MazinLab/huskypointofload/bom.xlsx

Reference | Qty | DIGIKEY_PN | Footprint | Value
Y1 | 1 | 2151-RH100-16.000-8-2020-TRCT-ND | Crystal:Crystal_SMD_3225-4Pin_3.2x2.5mm_HandSoldering | 16MHz
U11 | 1 | 4518-USBLC6-2SC6CT-ND | Package_TO_SOT_SMD:SOT-23-6 | USBLC6-2SC6
U10 | 1 | LTC2851IMS8#TRPBFCT-ND | Package_SO:SOIC-8_3.9x4.9mm_P1.27mm | LTC2851xS8
U9 | 1 | 497-STM32G474MBT6-ND | Package_QFP:LQFP-80_12x12mm_P0.5mm | STM32G474MBTx
U7,U8 | 2 | 505-LT3045EDD#PBF-ND | Package_DFN_QFN:DFN-10-1EP_3x3mm_P0.5mm_EP1.65x2.38mm | LT3045xDD
U5,U6 | 2 | 296-LMR36510ADDARCT-ND | Package_SO:Texas_HTSOP-8-1EP_3.9x4.9mm_P1.27mm_EP2.95x4.9mm_Mask2.4x3.1mm_ThermalVias | LMR36510ADDA
U4 | 1 | 505-LT8625SIV#TRMPBFCT-ND | Package_DFN_QFN:QFN-20-1EP_3x4mm_P0.5mm_EP1.65x2.65mm | LT8625S
U3 | 1 | 917-EPC23104ENGRTCT-ND | Package_DFN_QFN:EPC_QFN-13-3EP_3.5x5mm_P0.5mm | EPC23104
U1,U2 | 2 | 296-INA290A2IDCKRCT-ND | Package_TO_SOT_SMD:SOT-353_SC-70-5 | INA290A2xDCK
TP8 | 1 | 36-5015CT-ND | TestPoint:TestPoint_Keystone_5015_Micro_Mini | BOOT0
TP7 | 1 | 36-5015CT-ND | TestPoint:TestPoint_Keystone_5015_Micro_Mini | VBUS
TP6 | 1 | 36-5015CT-ND | TestPoint:TestPoint_Keystone_5015_Micro_Mini | LNSW
TP5 | 1 | 36-5015CT-ND | TestPoint:TestPoint_Keystone_5015_Micro_Mini | PHMODE
TP4 | 1 | 36-5015CT-ND | TestPoint:TestPoint_Keystone_5015_Micro_Mini | CLKOUT
TP3 | 1 | 36-5015CT-ND | TestPoint:TestPoint_Keystone_5015_Micro_Mini | VC
TP2 | 1 | 36-5015CT-ND | TestPoint:TestPoint_Keystone_5015_Micro_Mini | INTVCC
TP1 | 1 | 36-5015CT-ND | TestPoint:TestPoint_Keystone_5015_Micro_Mini | GANSW
SW2 | 1 | CKN10502CT-ND | Button_Switch_SMD:SW_SPST_PTS810 | BOOT0
SW1 | 1 | CKN10502CT-ND | Button_Switch_SMD:SW_SPST_PTS810 | SYS_RESET
R43,R44 | 2 | P27.0LCT-ND | Resistor_SMD:R_0402_1005Metric | 27
R39,R40 | 2 | 311-120LRCT-ND | Resistor_SMD:R_0402_1005Metric | 120
R33,R36 | 2 | 311-200KJRCT-ND | Resistor_SMD:R_0402_1005Metric | 200k
R31,R32 | 2 | YAG2304CT-ND | Resistor_SMD:R_0402_1005Metric | 100k
R29,R34,R37 | 3 | 311-10.0LRCT-ND | Resistor_SMD:R_0402_1005Metric | 10
R28 | 1 | YAG4390CT-ND | Resistor_SMD:R_0402_1005Metric | 47.5k
R26 | 1 | 311-499LRCT-ND | Resistor_SMD:R_0402_1005Metric | 499
R23,R24,R27 | 3 | YAG3471CT-ND | Resistor_SMD:R_0402_1005Metric | 2.2
R21,R22,R25,R41,R42 | 5 | 311-4.7KJRCT-ND | Resistor_SMD:R_0402_1005Metric | 4.7k
R19,R20 | 2 | 311-0.0JRCT-ND | Resistor_SMD:R_0402_1005Metric | 0
R16,R18 | 2 | YAG4374CT-ND | Resistor_SMD:R_0402_1005Metric | 33k
R15,R17 | 2 | 13-RC0402FR-13453KLCT-ND | Resistor_SMD:R_0402_1005Metric | 453k
R14 | 1 | 738-RNCF0402BTE40K0CT-ND | Resistor_SMD:R_0402_1005Metric | 40k
R13 | 1 | YAG3129CT-ND | Resistor_SMD:R_0402_1005Metric | 357k
R10 | 1 | P43.2KDCCT-ND | Resistor_SMD:R_0402_1005Metric | 43.2k
R9 | 1 | YAG4360CT-ND | Resistor_SMD:R_0402_1005Metric | 24.9k
R7 | 1 | 541-MCS0402MD1004BE000CT-ND | Resistor_SMD:R_0402_1005Metric | 1M
R4,R5,R6,R8,R12,R30,R35,R38 | 8 | YAG4394CT-ND | Resistor_SMD:R_0402_1005Metric | 49.9k
R3,R11 | 2 | 2019-RN73R1ETTP2673B25CT-ND | Resistor_SMD:R_0402_1005Metric | 267k
R1,R2 | 2 | YAG2145CT-ND | Resistor_SMD:R_2512_6332Metric | 5m
L5,L6 | 2 | SRN6045-220MCT-ND | Inductor_SMD:L_Bourns_SRN6045TA | 22u
L4 | 1 | 118-SRP7028AA-R22MCT-ND | Inductor_SMD:L_Bourns_SRP7028A_7.3x6.6mm | 220n
L3 | 1 | SRP5030T-1R0MCT-ND | Inductor_SMD:L_Bourns_SRP5030T | 1u
L2 | 1 | SRP1245A-1R5MCT-ND | Inductor_SMD:L_Bourns_SRP1245A | 1.5u
L1 | 1 | SRR1260-1R0YCT-ND | Inductor_SMD:L_Bourns_SRR1260 | 1u
J9 | 1 | 670-DX07S016JA1R1500CT-ND | Connector_USB:USB_C_Receptacle_JAE_DX07S016JA1R1500 | USB-C
J8 | 1 | SAM1161-05-ND | Connector_PinHeader_1.27mm:PinHeader_2x05_P1.27mm_Vertical_SMD | JTAG
J7 | 1 | 2946-233-504-ND | TerminalBlock_WAGO:TerminalBlock_WAGO_233-504_2x04_P2.54mm | RS485
J3 | 1 | 2946-2601-1102-ND | TerminalBlock_WAGO:TerminalBlock_WAGO_2601-1102_1x02_P3.50mm_Horizontal | RFSOC_POWER
J2,J4,J5,J6 | 4 | ARF2755-ND | Connector_Coaxial:SMA_Amphenol_132134-10_Vertical | VSENSE
J1 | 1 | 2946-2601-1105-ND | TerminalBlock_WAGO:TerminalBlock_WAGO_2601-1105_1x05_P3.50mm_Horizontal | POWER
FB1 | 1 | 732-6119-1-ND | Inductor_SMD:L_0603_1608Metric | 74279228600
F2 | 1 | F2973CT-ND | Fuse:Fuseholder_Littelfuse_Nano2_157x | 5A
F1 | 1 | F2973CT-ND | Fuse:Fuseholder_Littelfuse_Nano2_157x | 10A
D1,D2,D3,D4,D5,D6,D7,D8 | 8 | DFLS1150DICT-ND | Diode_SMD:D_PowerDI-123 | DFLS1150
C78,C80 | 2 | 490-13339-1-ND | Capacitor_SMD:C_0402_1005Metric | 1u
C76,C77 | 2 | 490-11190-1-ND | Capacitor_SMD:C_0402_1005Metric | 12p
C71,C74 | 2 |  | Capacitor_SMD:C_0201_0603Metric | DNP
C70,C73 | 2 | 490-10727-1-ND | Capacitor_SMD:C_0603_1608Metric | 10u
C69,C72 | 2 | 490-GRM31CZ72A475ME11LCT-ND | Capacitor_SMD:C_1206_3216Metric | 4.7u
C59,C60,C61,C66,C67,C68 | 6 | 490-14659-1-ND | Capacitor_SMD:C_0603_1608Metric | 22u
C56,C63 | 2 | 490-GRM155R61J224ME01JCT-ND | Capacitor_SMD:C_0402_1005Metric | 220n
C54 | 1 | 490-GCM155R71H471KA37JCT-ND | Capacitor_SMD:C_0402_1005Metric | 470p
C52 | 1 | 490-13981-1-ND | Capacitor_SMD:C_0805_2012Metric | 100u
C50,C51 | 2 | 490-NFM18PC106D0J3LCT-ND | Capacitor_SMD:C_0402_1005Metric | 10u
C48 | 1 | 490-GRM155R60J226ME11DCT-ND | Capacitor_SMD:C_0402_1005Metric | 22u
C47,C49 | 2 | 490-GRM033R60J225ME01DCT-ND | Capacitor_SMD:C_0201_0603Metric | 2.2u
C44 | 1 | 490-GCM1555C1H820JA16DCT-ND | Capacitor_SMD:C_0402_1005Metric | 82p
C43,C75,C79 | 3 | 490-6351-1-ND | Capacitor_SMD:C_0402_1005Metric | 10n
C41,C46,C57,C64 | 4 | 490-14409-1-ND | Capacitor_SMD:C_0402_1005Metric | 1u
C22 | 1 | 490-GRM022R61C104ME05LCT-ND | Capacitor_SMD:C_0402_1005Metric | 100n
C19,C21,C53 | 3 |  | Capacitor_SMD:C_0402_1005Metric | DNP
C18,C20 | 2 | 490-6418-1-ND | Capacitor_SMD:C_0603_1608Metric | 2.2u
C14,C16,C17 | 3 | 490-5839-1-ND | Capacitor_SMD:C_2220_5750Metric | 22u
C8,C10,C12,C55,C62 | 5 | 490-GRM21BD72A225ME01KCT-ND | Capacitor_SMD:C_0805_2012Metric | 2.2u
C7,C9,C11,C13,C15 | 5 | 490-3285-1-ND | Capacitor_SMD:C_0603_1608Metric | 100n
C4,C5,C6,C23,C24,C25,C26,C27,C34,C35,C36,C37 | 12 | 490-GRM31CC71E226ME15LCT-ND | Capacitor_SMD:C_1206_3216Metric | 22u
C3,C28,C29,C30,C31,C32,C33,C38,C39,C40,C42 | 11 | 490-12732-1-ND | Capacitor_SMD:C_0603_1608Metric | 2.2u
C1,C2,C45,C58,C65,C81,C82,C83,C84,C85,C86 | 11 | 490-14603-1-ND | Capacitor_SMD:C_0402_1005Metric | 100n
