MazinLab/huskypointofload/huskypointofload.pdf

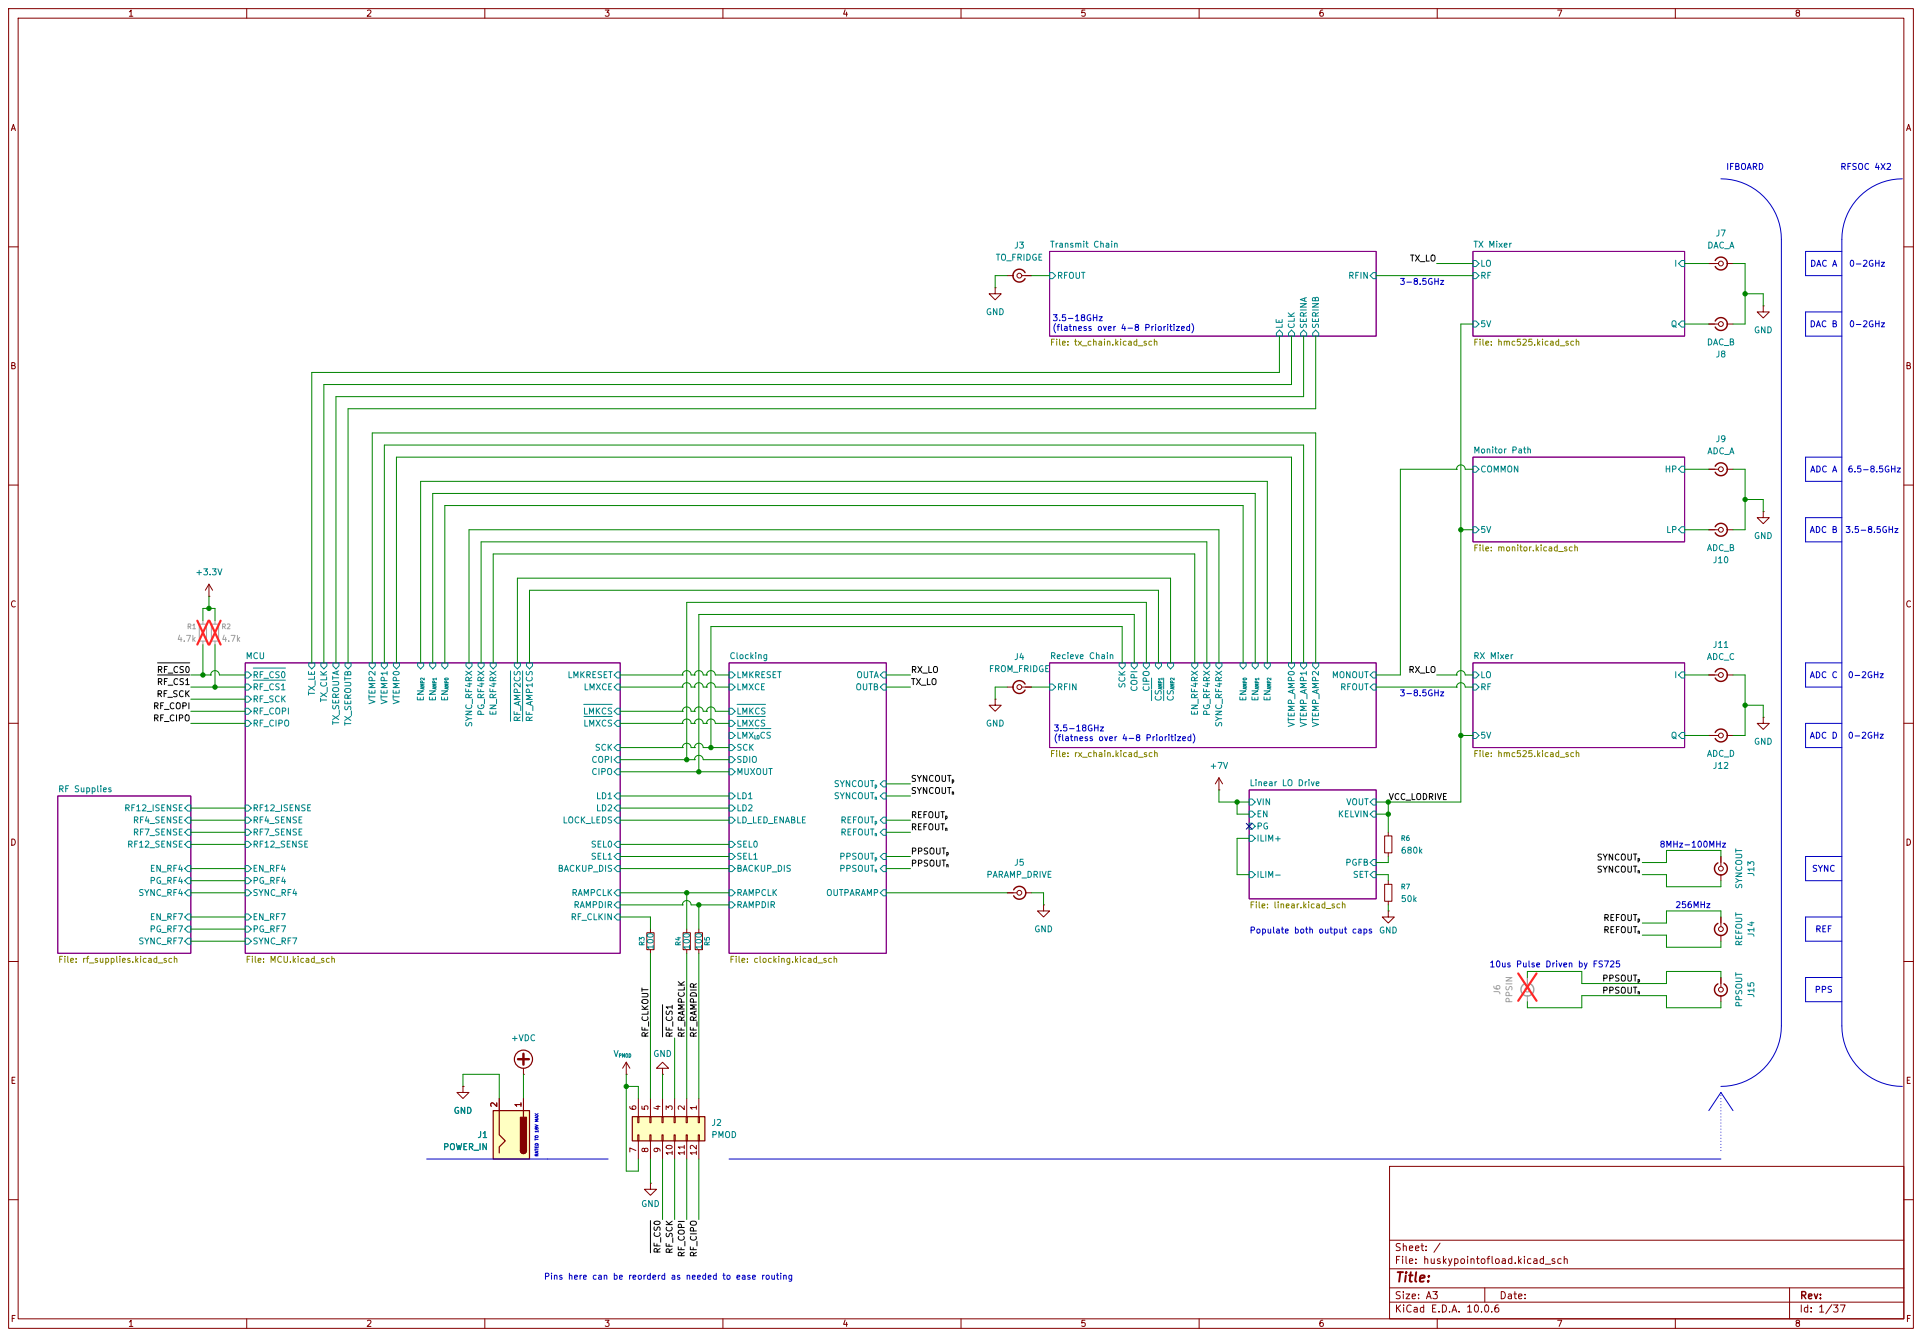
[picture p1: page 1]

TX Mixer File: hmc525.kicad_sch LECLK

LMKRESET BACKUP_DIS RAMPCLK
0-2GHz Pins here can be reorderd as needed to ease routing RATED TO 18V MAX

Populate both output caps

Size: A3 | Rev: | F Date:
KiCad E.D.A. 10.0.6 | Id: 1/37

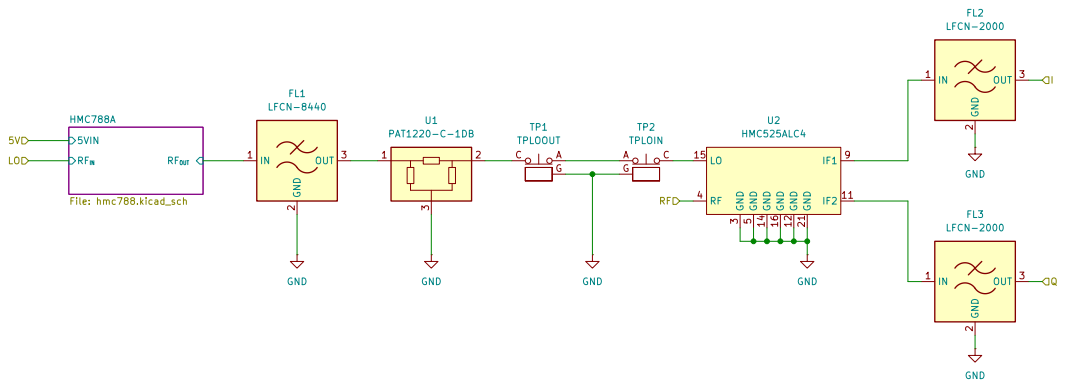
[picture p2: page 2]

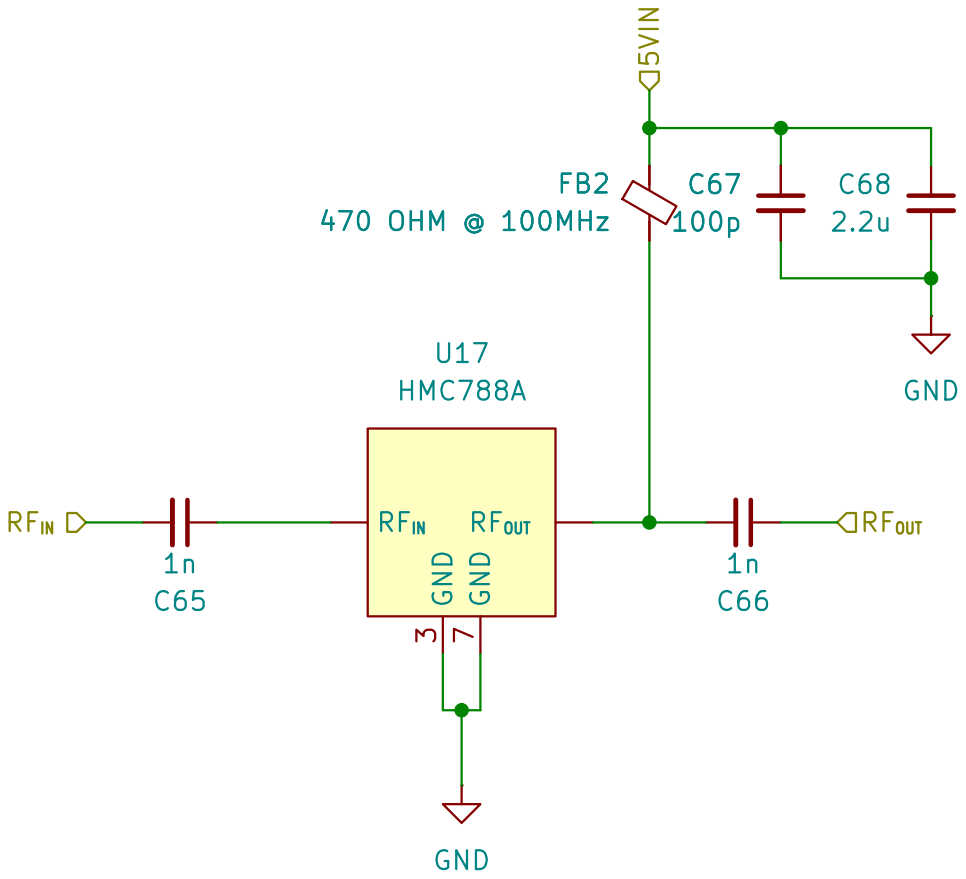
[picture p3: page 3]

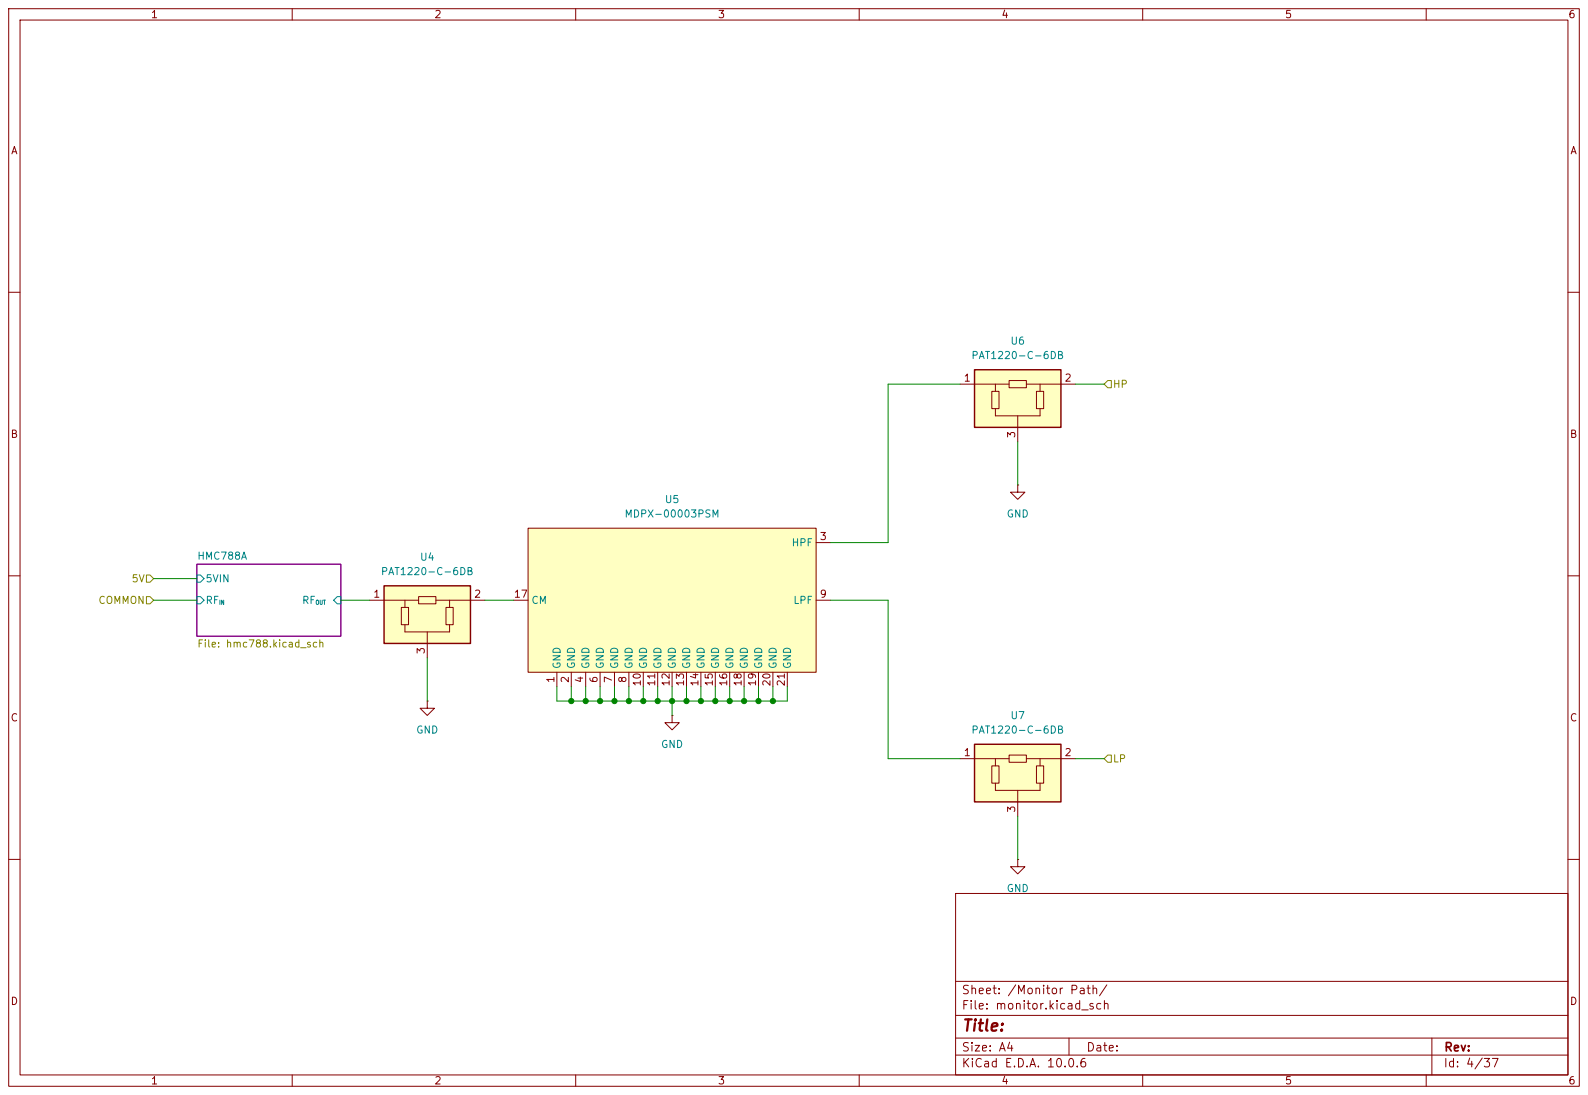
[picture p4: page 4]

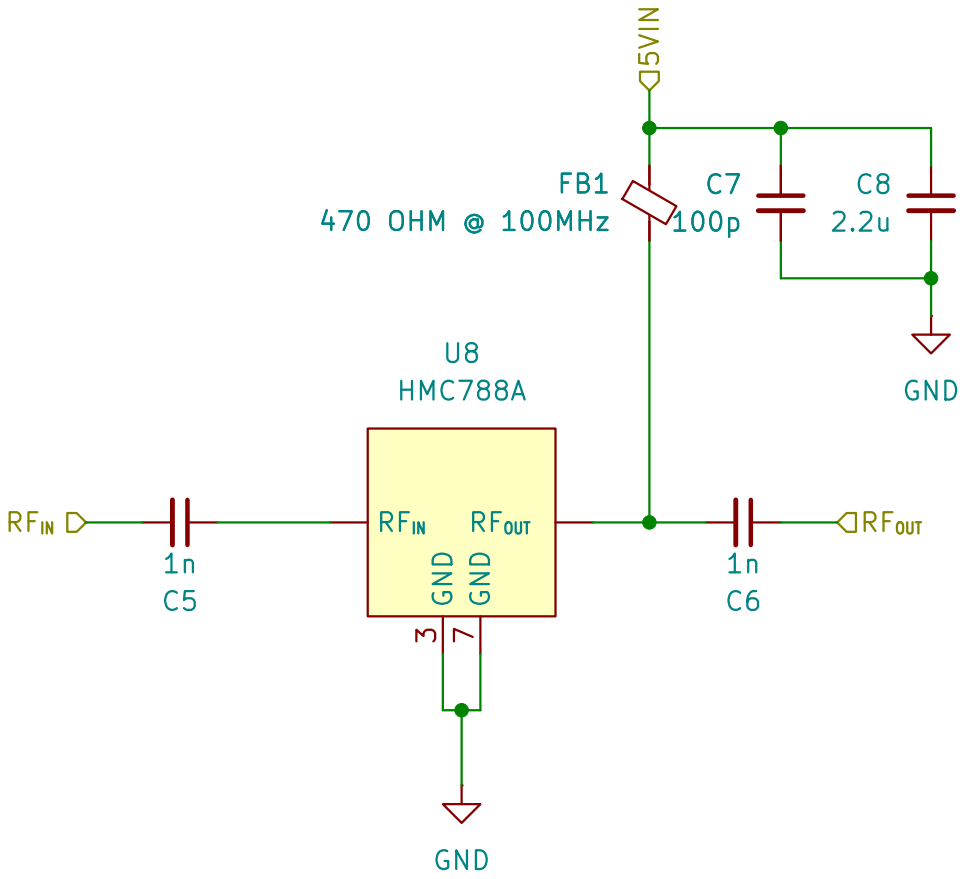
[picture p5: page 5]

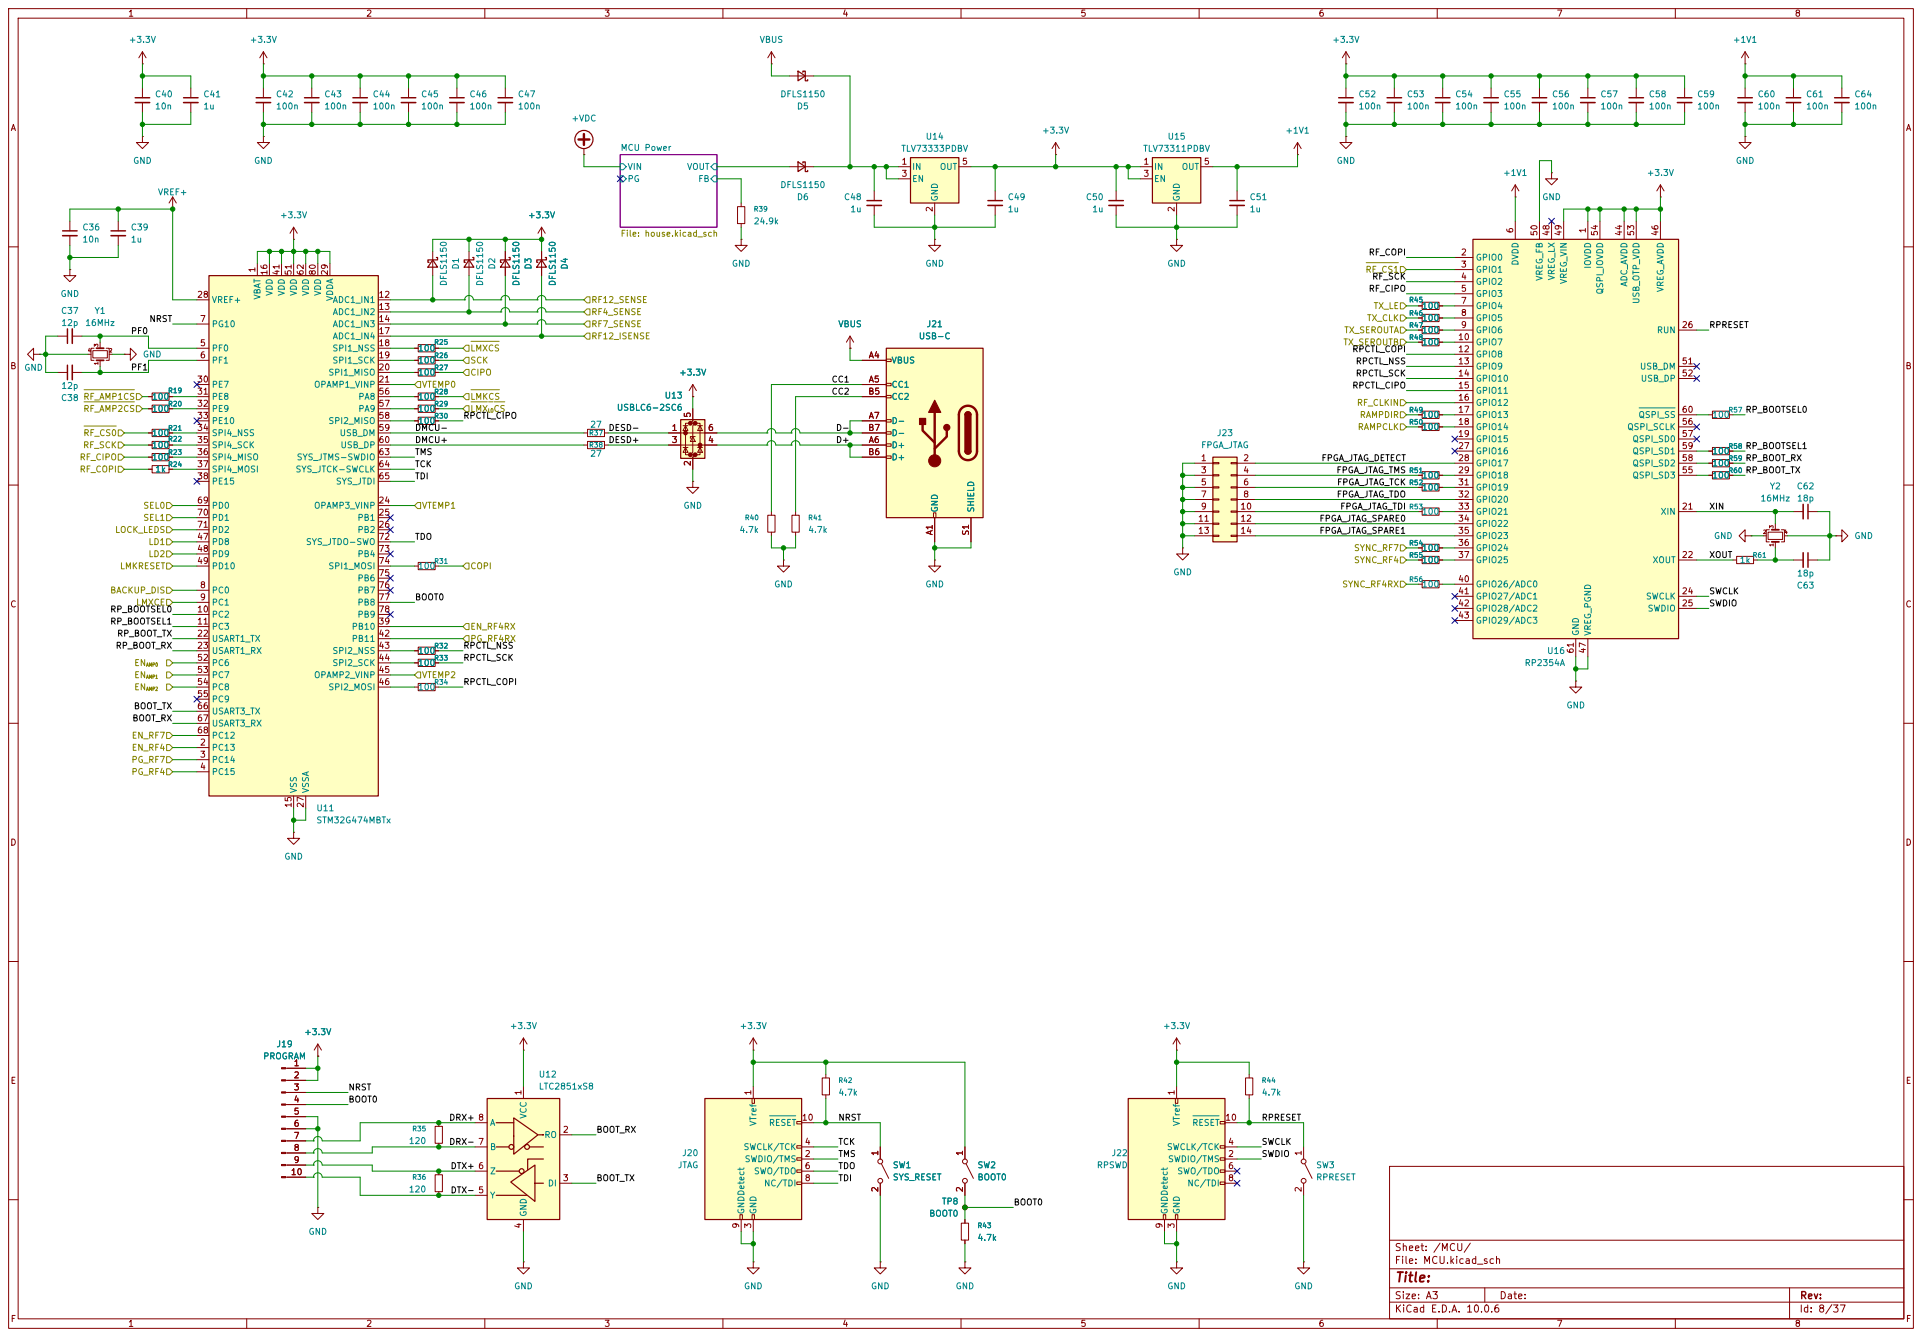
[picture p6: page 6]

7 | R52100 R52100 8 FPGA_JTAG_TDI FPGA_JTAG_TDO

11 | 12 FPGA_JTAG_SPARE0
13 | 14

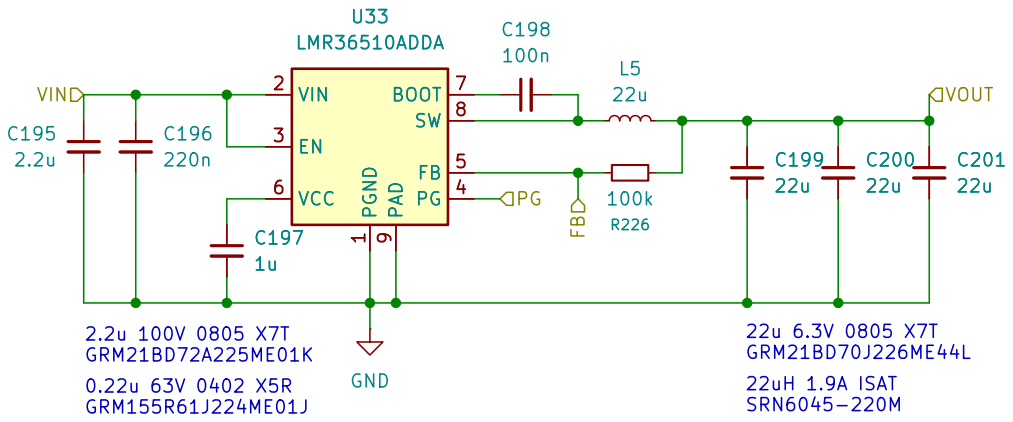
[picture p7: page 7]

Sheet: /MCU/MCU Power/
File: house.kicad_sch

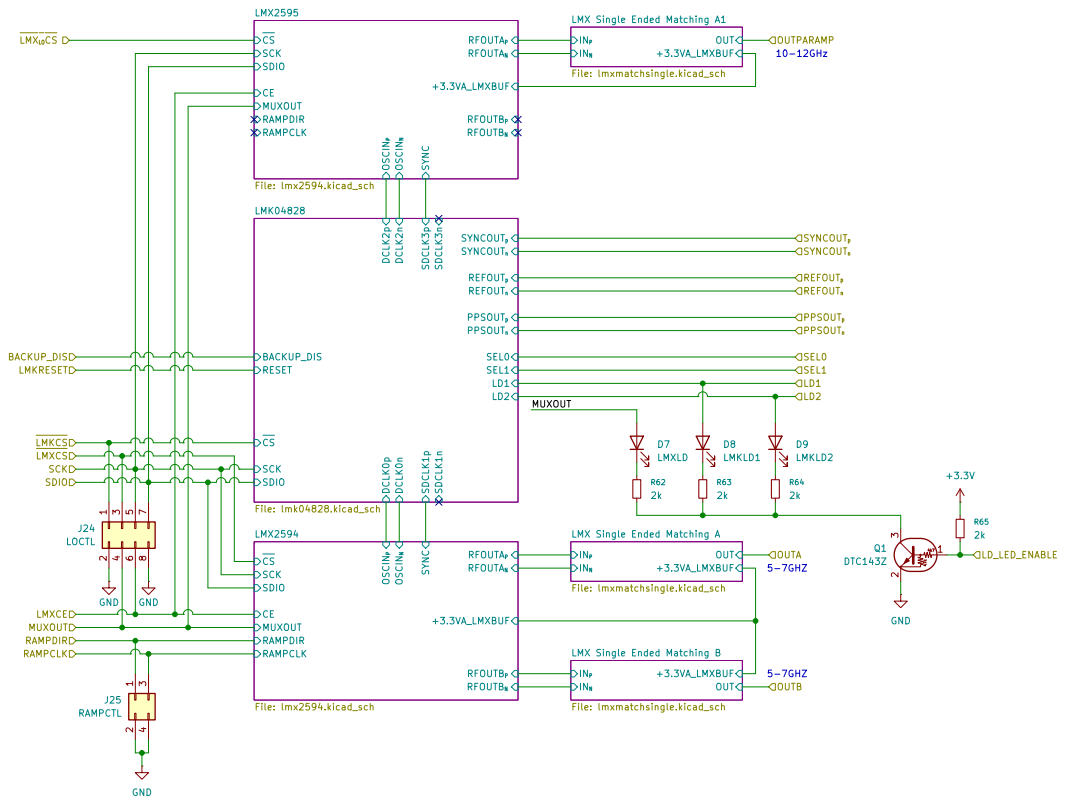
[picture p8: page 8]

LMX Single Ended Matching A1

RFOUTAN RFOUTAP RFOUTBN RFOUTBP SCK

LMX Single Ended Matching A

LMX Single Ended Matching B

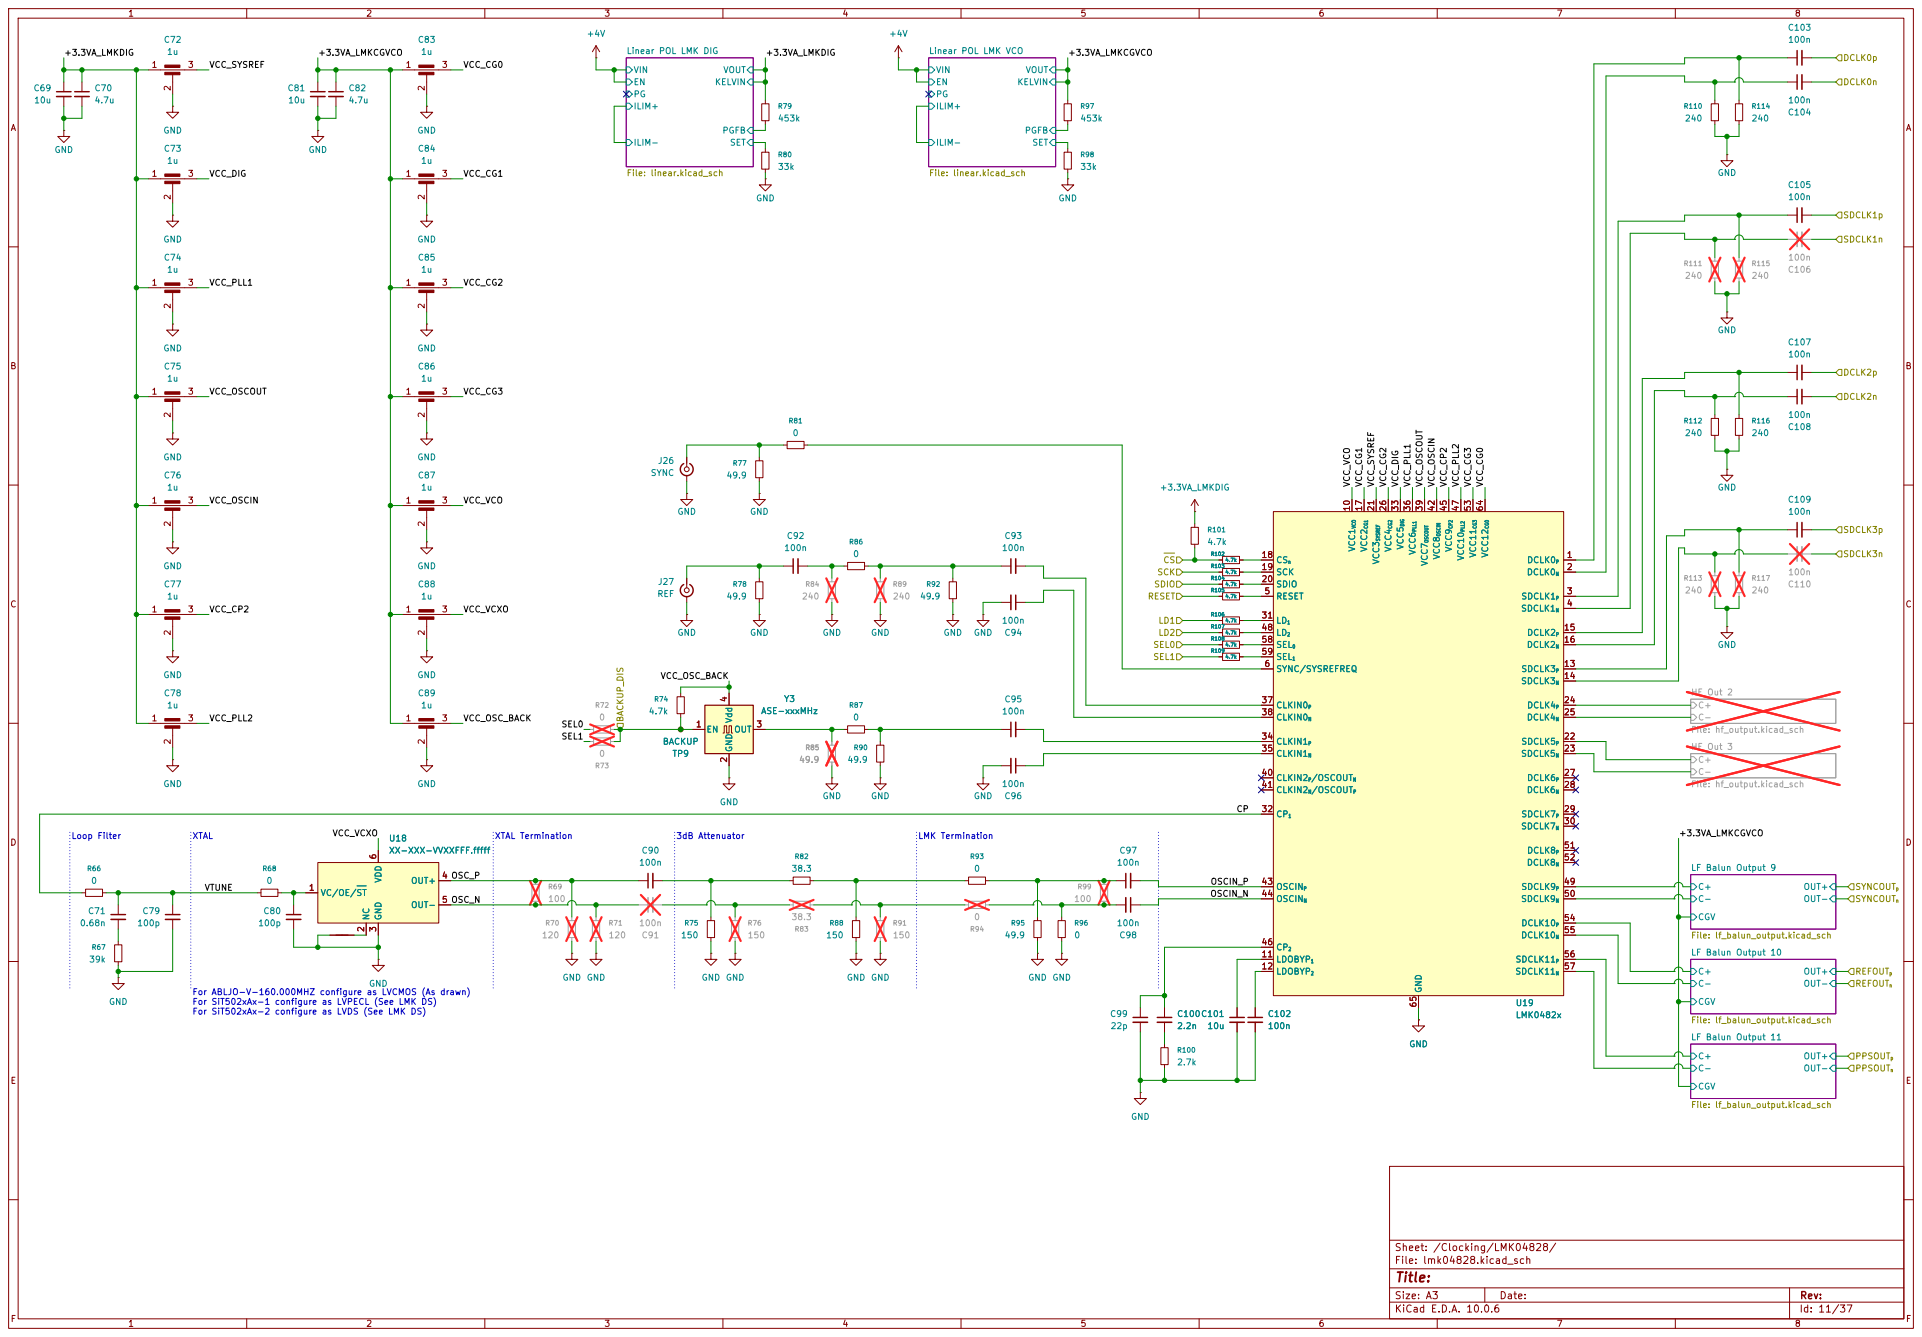
[picture p9: page 9]

Linear POL LMK DIG

Linear POL LMK VCO

PPSOUTn PPSOUTp REFOUTp REFOUTn SYNCOUTn SYNCOUTp BACKUP_DIS

3dB Attenuator For ABLJO-V-160.000MHZ configure as LVCMOS (As drawn) For SiT502xAx-1 configure as LVPECL (See LMK DS) For SiT502xAx-2 configure as LVDS (See LMK DS)

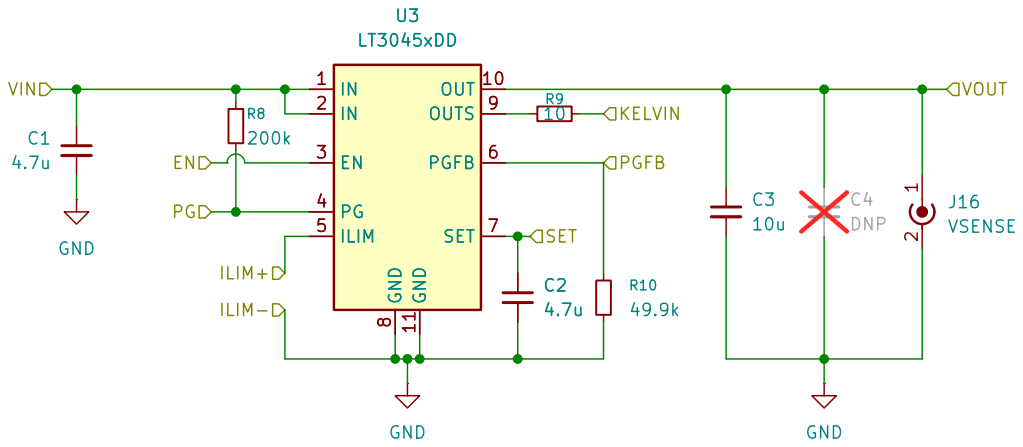
[picture p10: page 10]

Sheet: /Clocking/LMK04828/Linear POL LMK DIG/
File: linear.kicad_sch

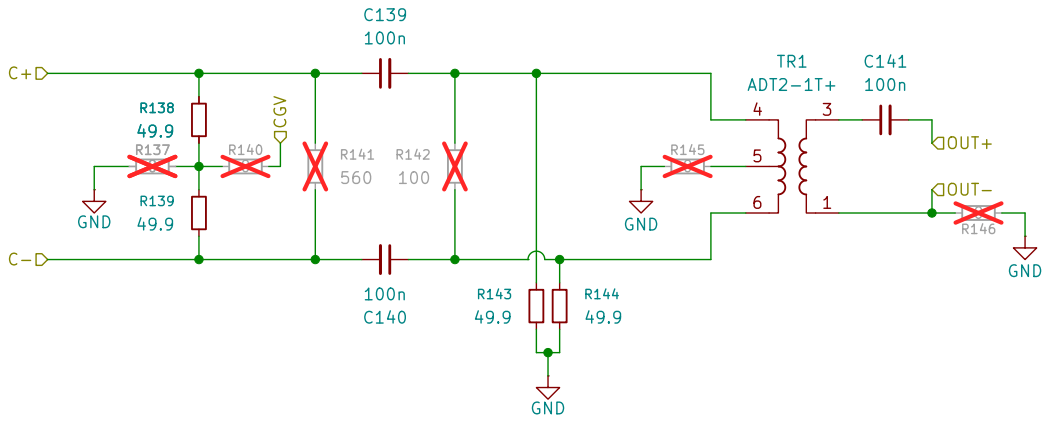
[picture p11: page 11]

Sheet: /Clocking/LMK04828/LF Balun Output 9/
File: lf_balun_output.kicad_sch
Title:

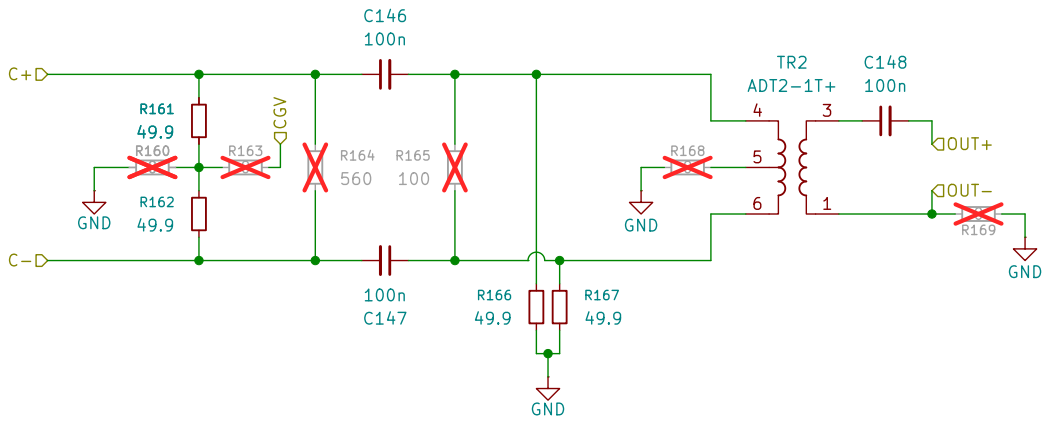
[picture p12: page 12]

Sheet: /Clocking/LMK04828/LF Balun Output 10/
File: lf_balun_output.kicad_sch
Title:

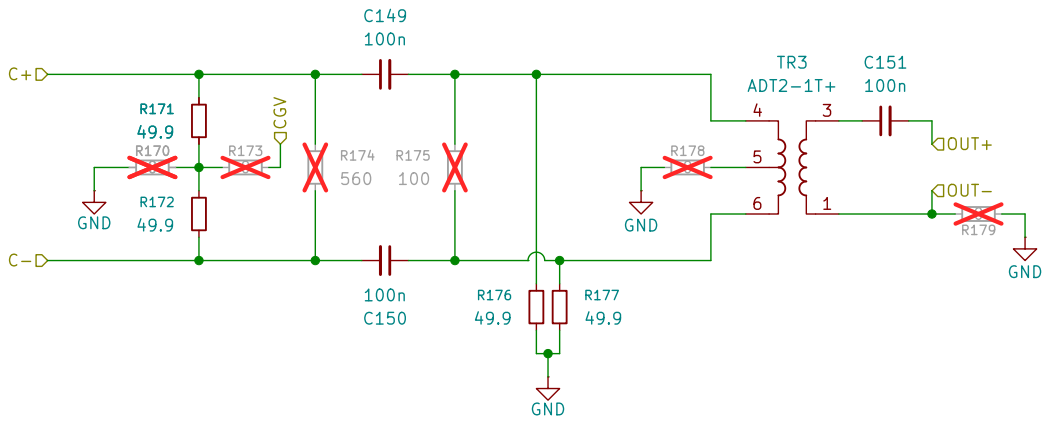
[picture p13: page 13]

Sheet: /Clocking/LMK04828/LF Balun Output 11/
File: lf_balun_output.kicad_sch
Title:

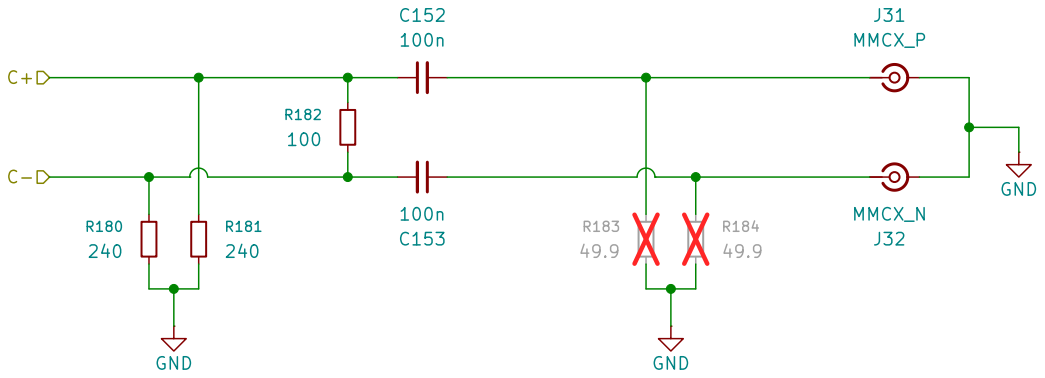
[picture p14: page 14]

Sheet: /Clocking/LMK04828/HF Out 2/
File: hf_output.kicad_sch
Title:

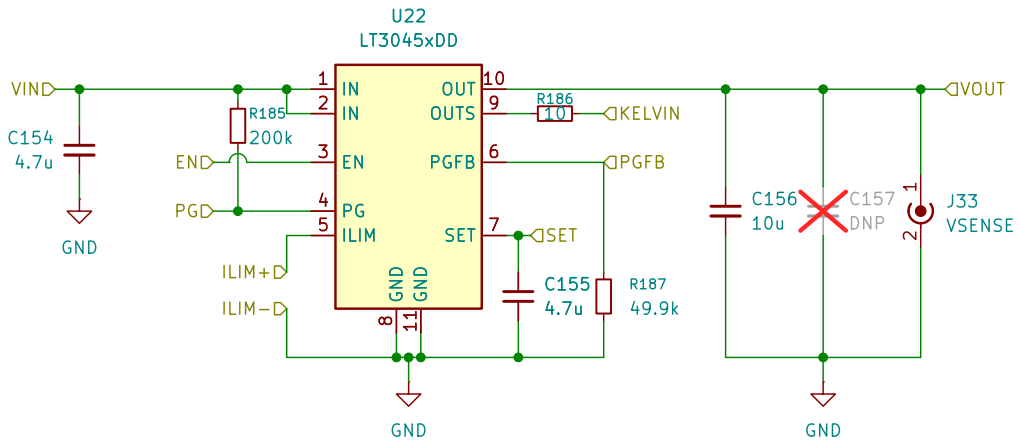
[picture p15: page 15]

Sheet: /Clocking/LMK04828/Linear POL LMK VCO/
File: linear.kicad_sch

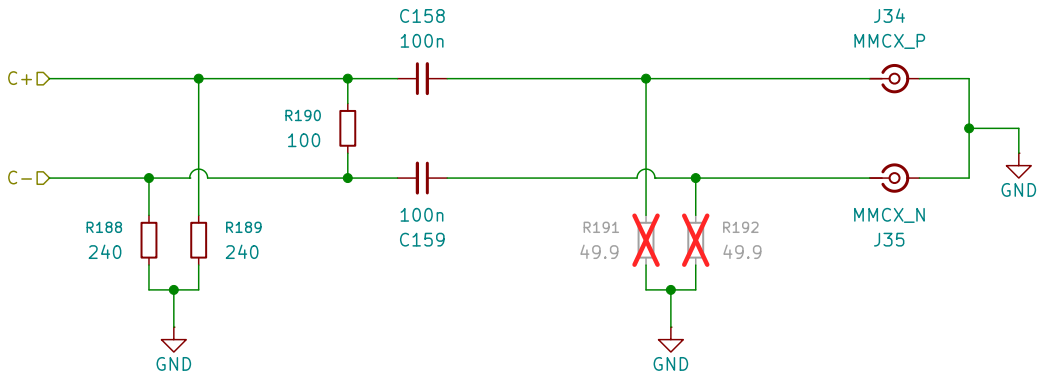
[picture p16: page 16]

Sheet: /Clocking/LMK04828/HF Out 3/
File: hf_output.kicad_sch
Title:

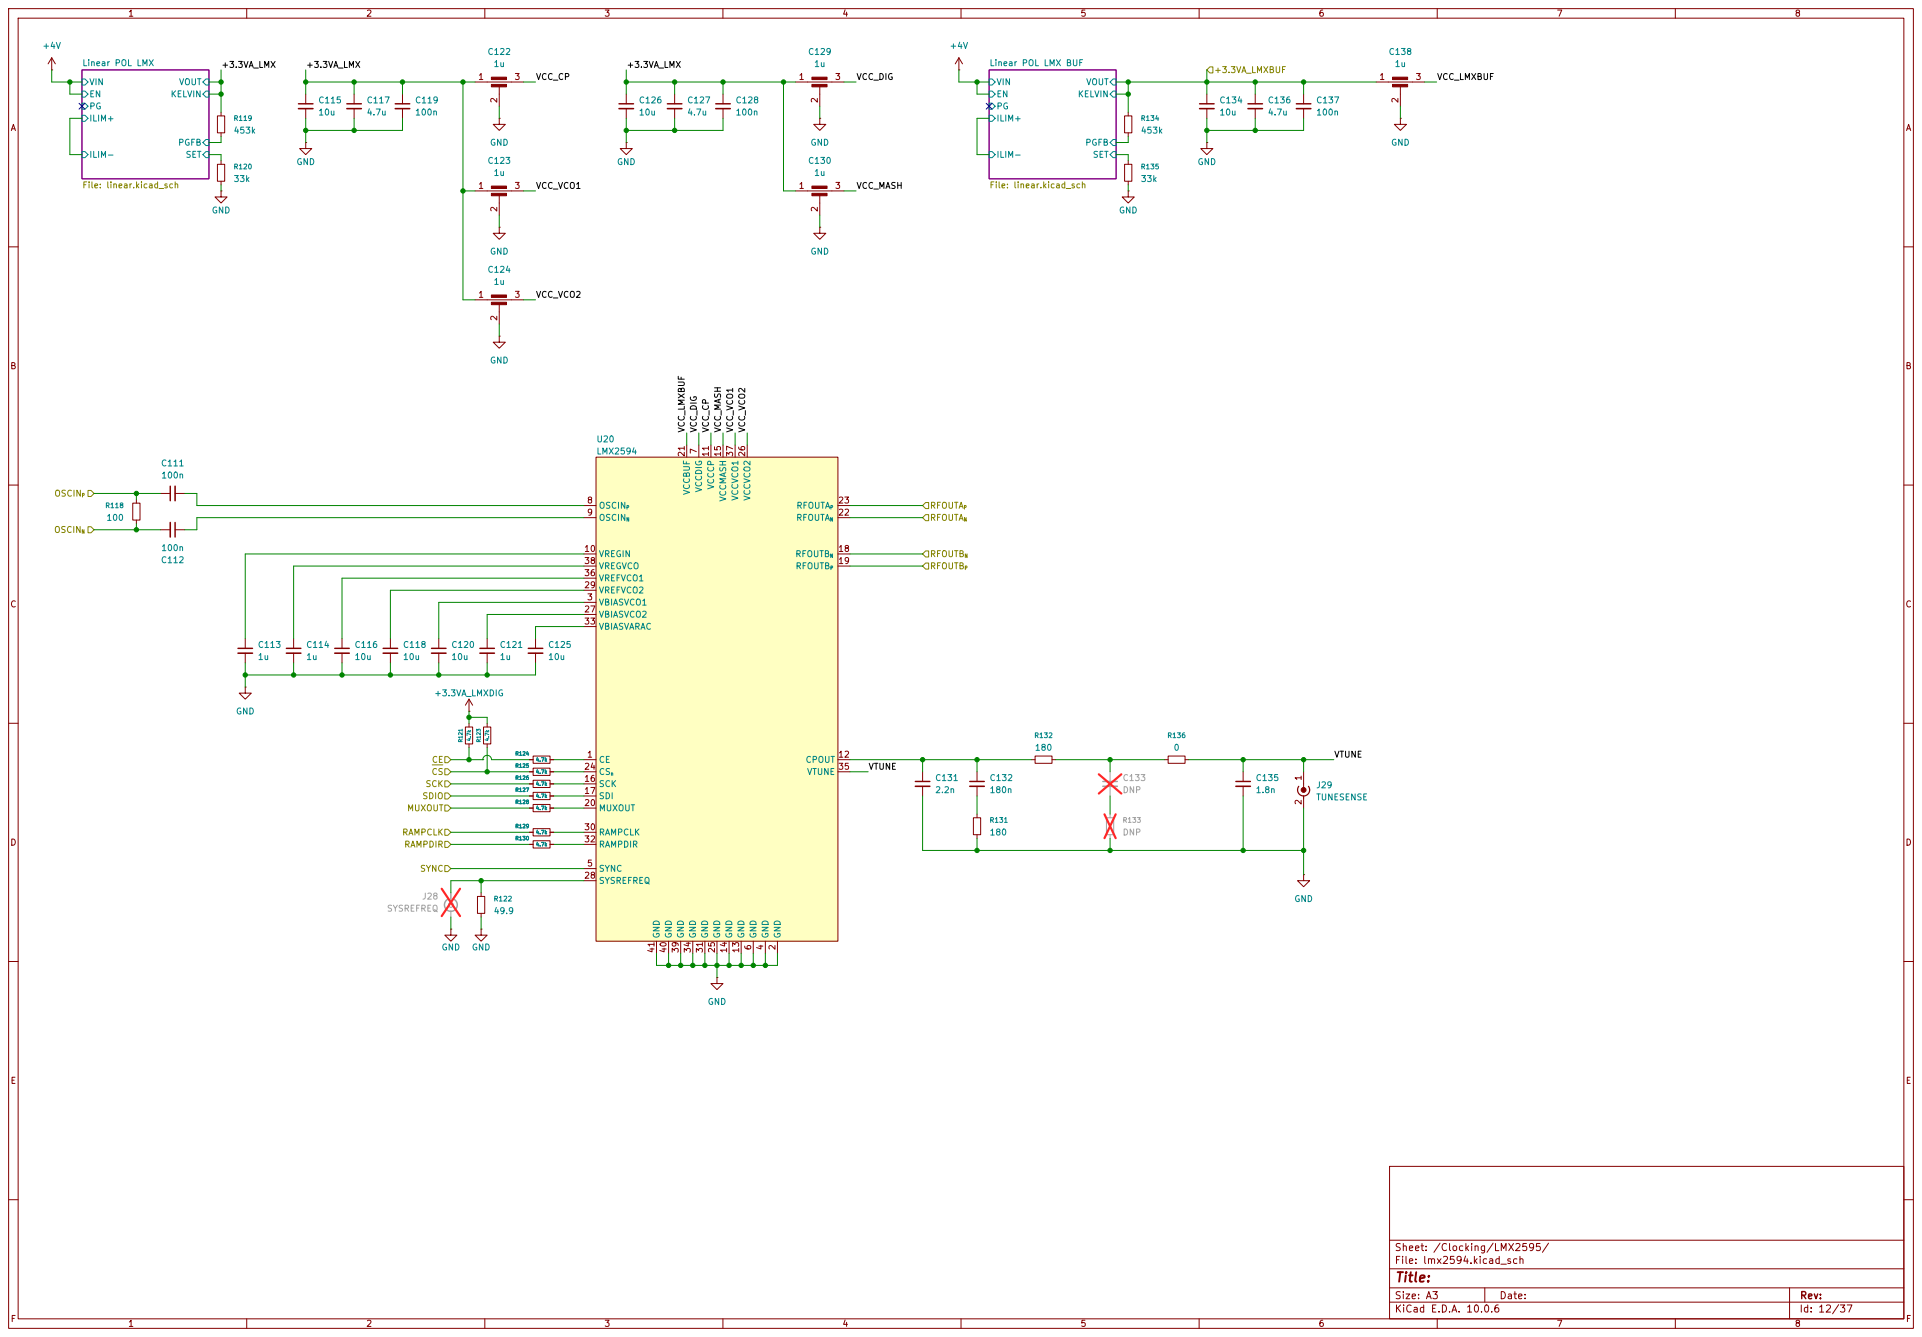
[picture p17: page 17]

+3.3VA_LMXBUF RFOUTAN RFOUTBN RFOUTBP RFOUTAP RAMPDIR

Linear POL LMX BUF

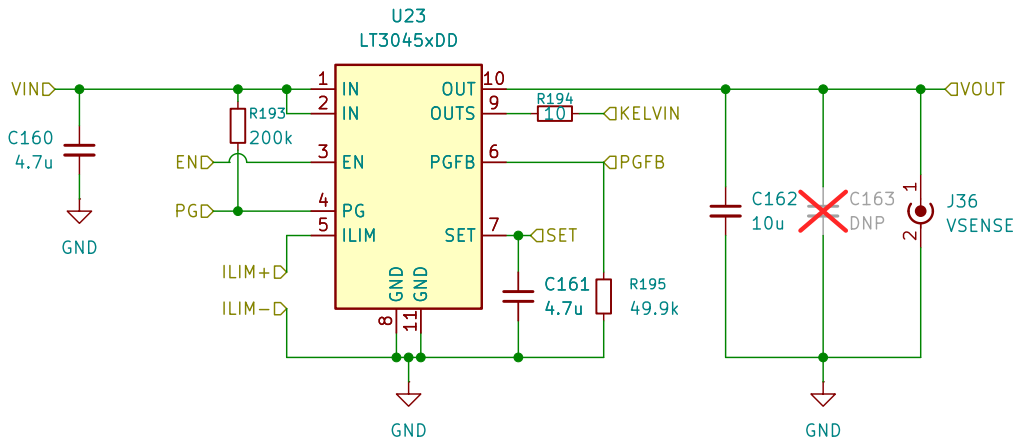
[picture p18: page 18]

Sheet: /Clocking/LMX2595/Linear POL LMX BUF/
File: linear.kicad_sch

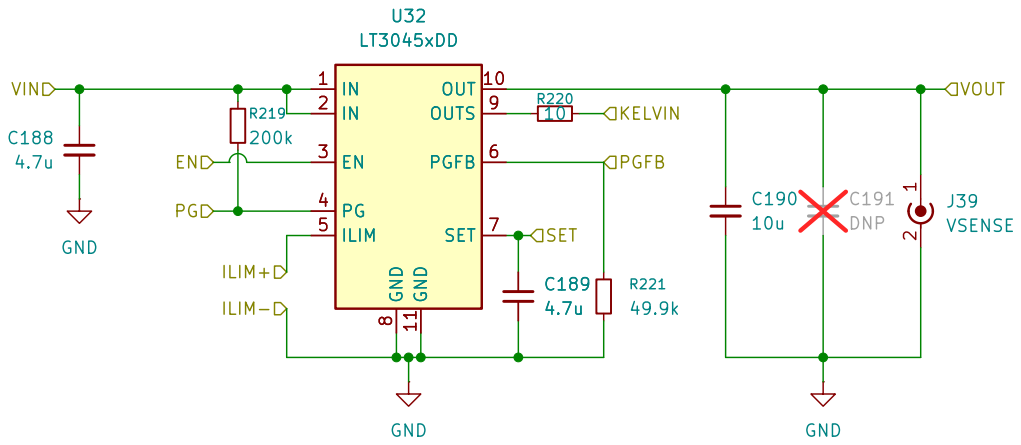
[picture p19: page 19]

Sheet: /Clocking/LMX2595/Linear POL LMX/
File: linear.kicad_sch

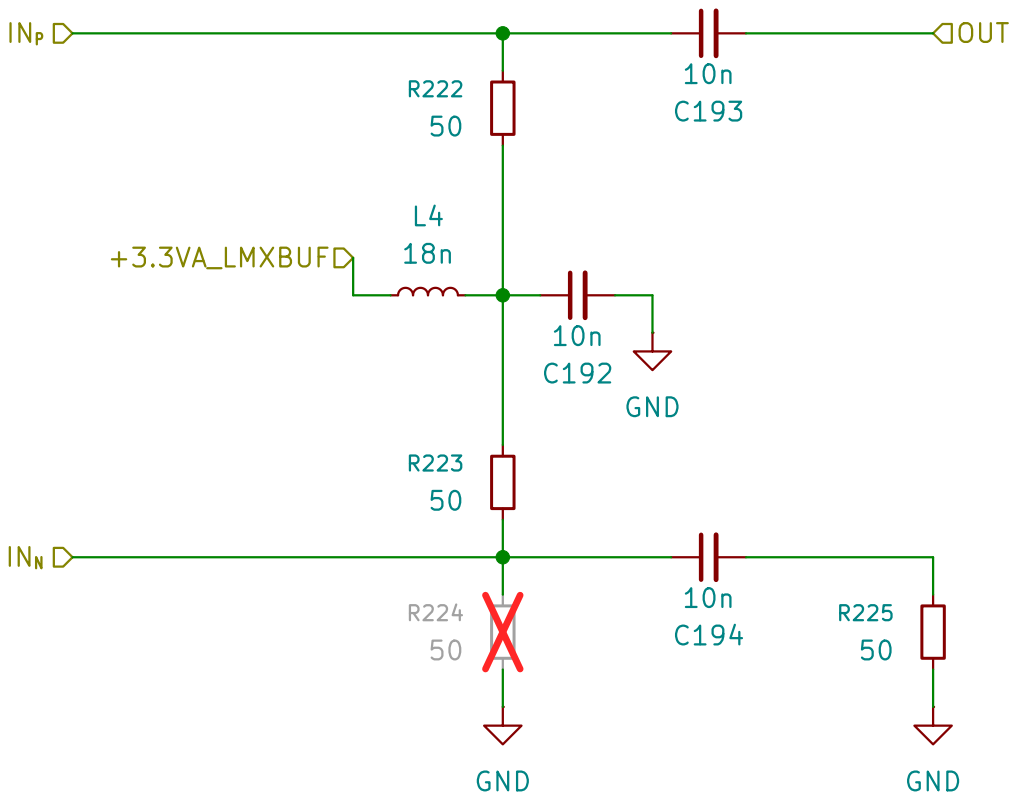
[picture p20: page 20]

Sheet: /Clocking/LMX Single Ended Matching A1/
File: lmxmatchsingle.kicad_sch
Title:

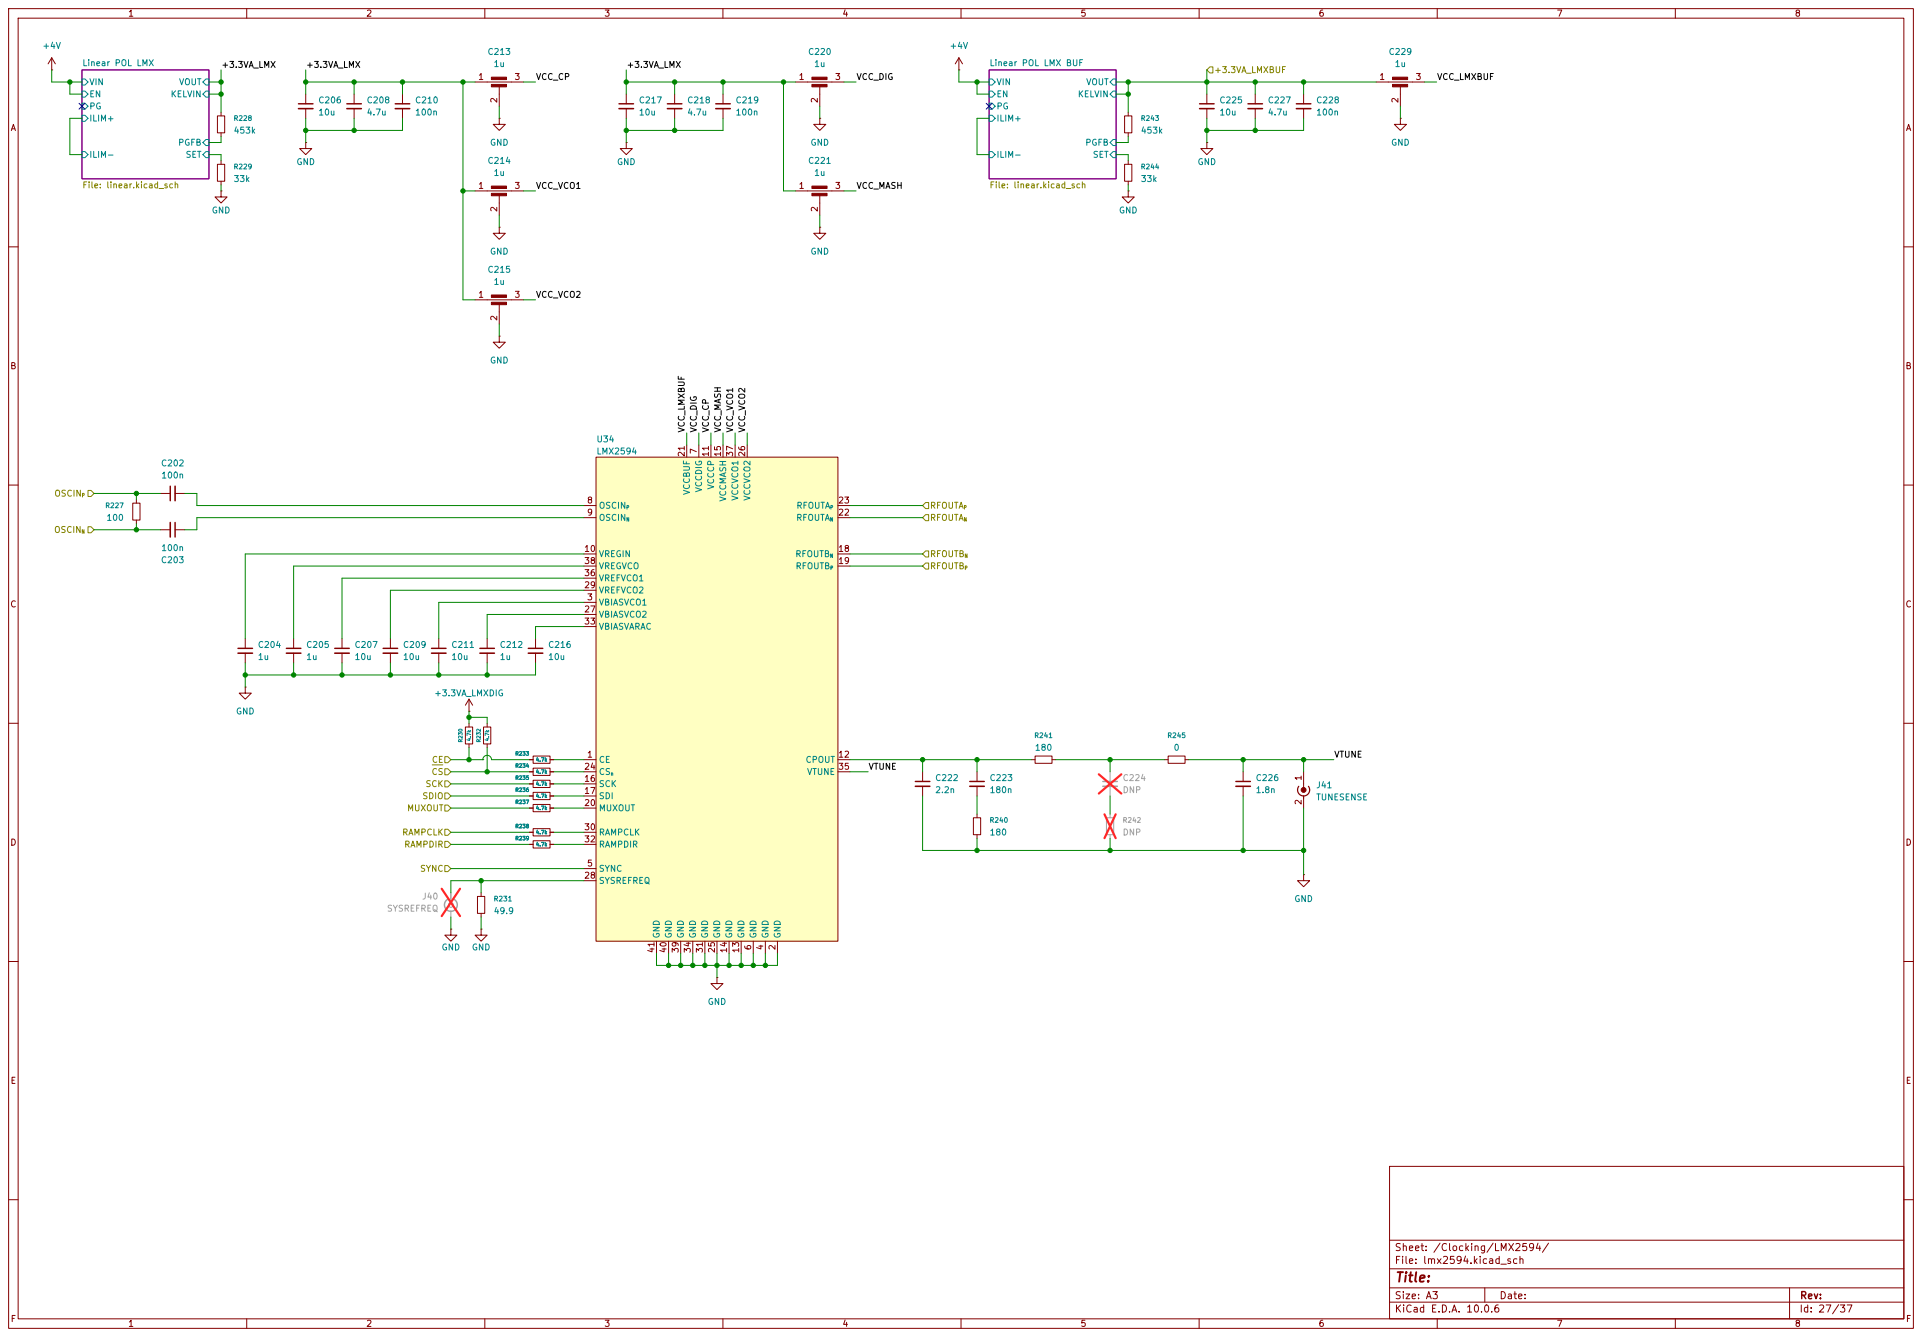
[picture p21: page 21]

+3.3VA_LMXBUF RFOUTAN RFOUTBN RFOUTBP RFOUTAP RAMPDIR

Linear POL LMX BUF

4.7k R234 4.7k R234 4.7k | SCK 16

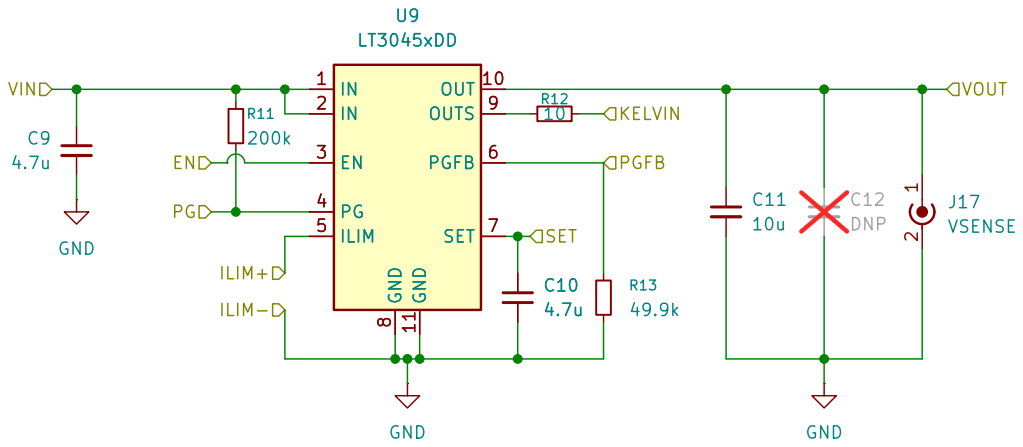
[picture p22: page 22]

Sheet: /Clocking/LMX2594/Linear POL LMX/
File: linear.kicad_sch

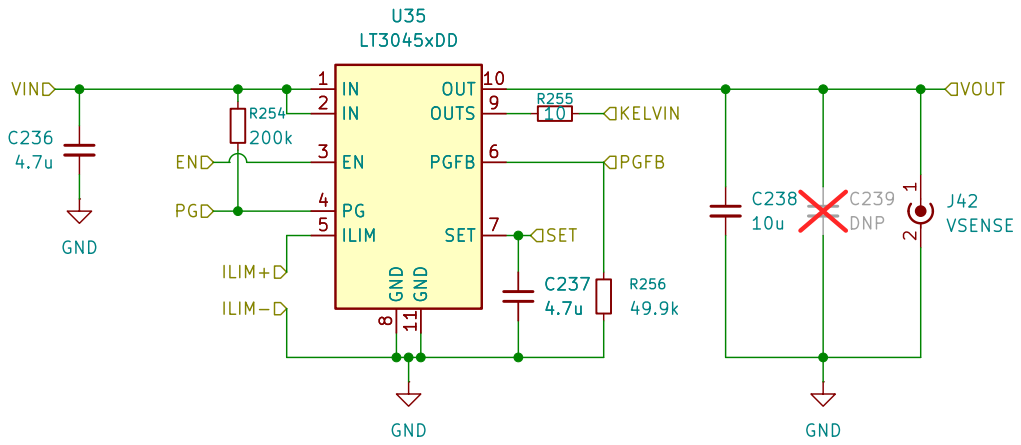
[picture p23: page 23]

Sheet: /Clocking/LMX2594/Linear POL LMX BUF/
File: linear.kicad_sch

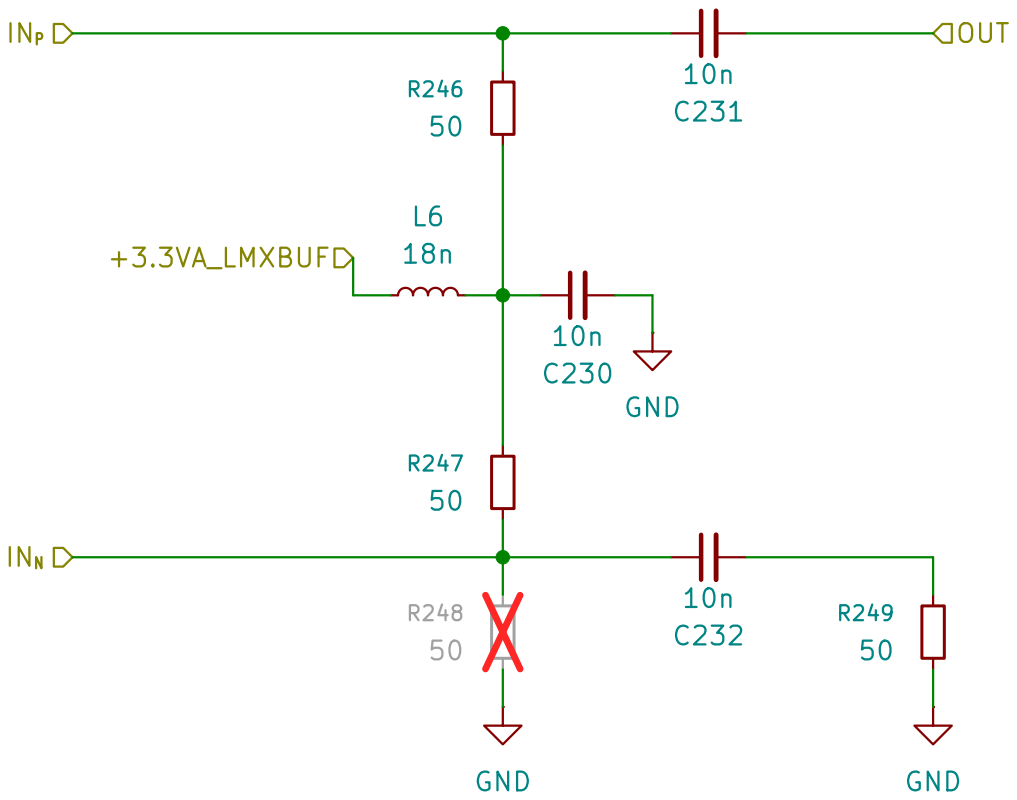
[picture p24: page 24]

Sheet: /Clocking/LMX Single Ended Matching A/
File: lmxmatchsingle.kicad_sch
Title:

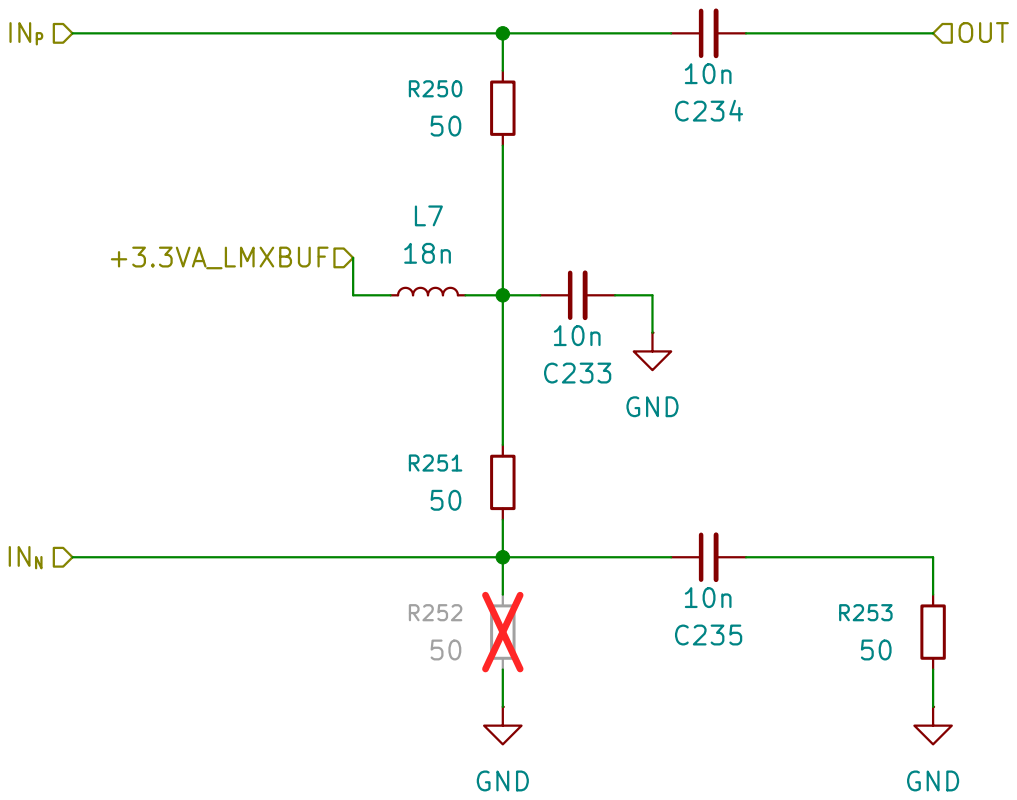
[picture p25: page 25]

Sheet: /Clocking/LMX Single Ended Matching B/
File: lmxmatchsingle.kicad_sch
Title:

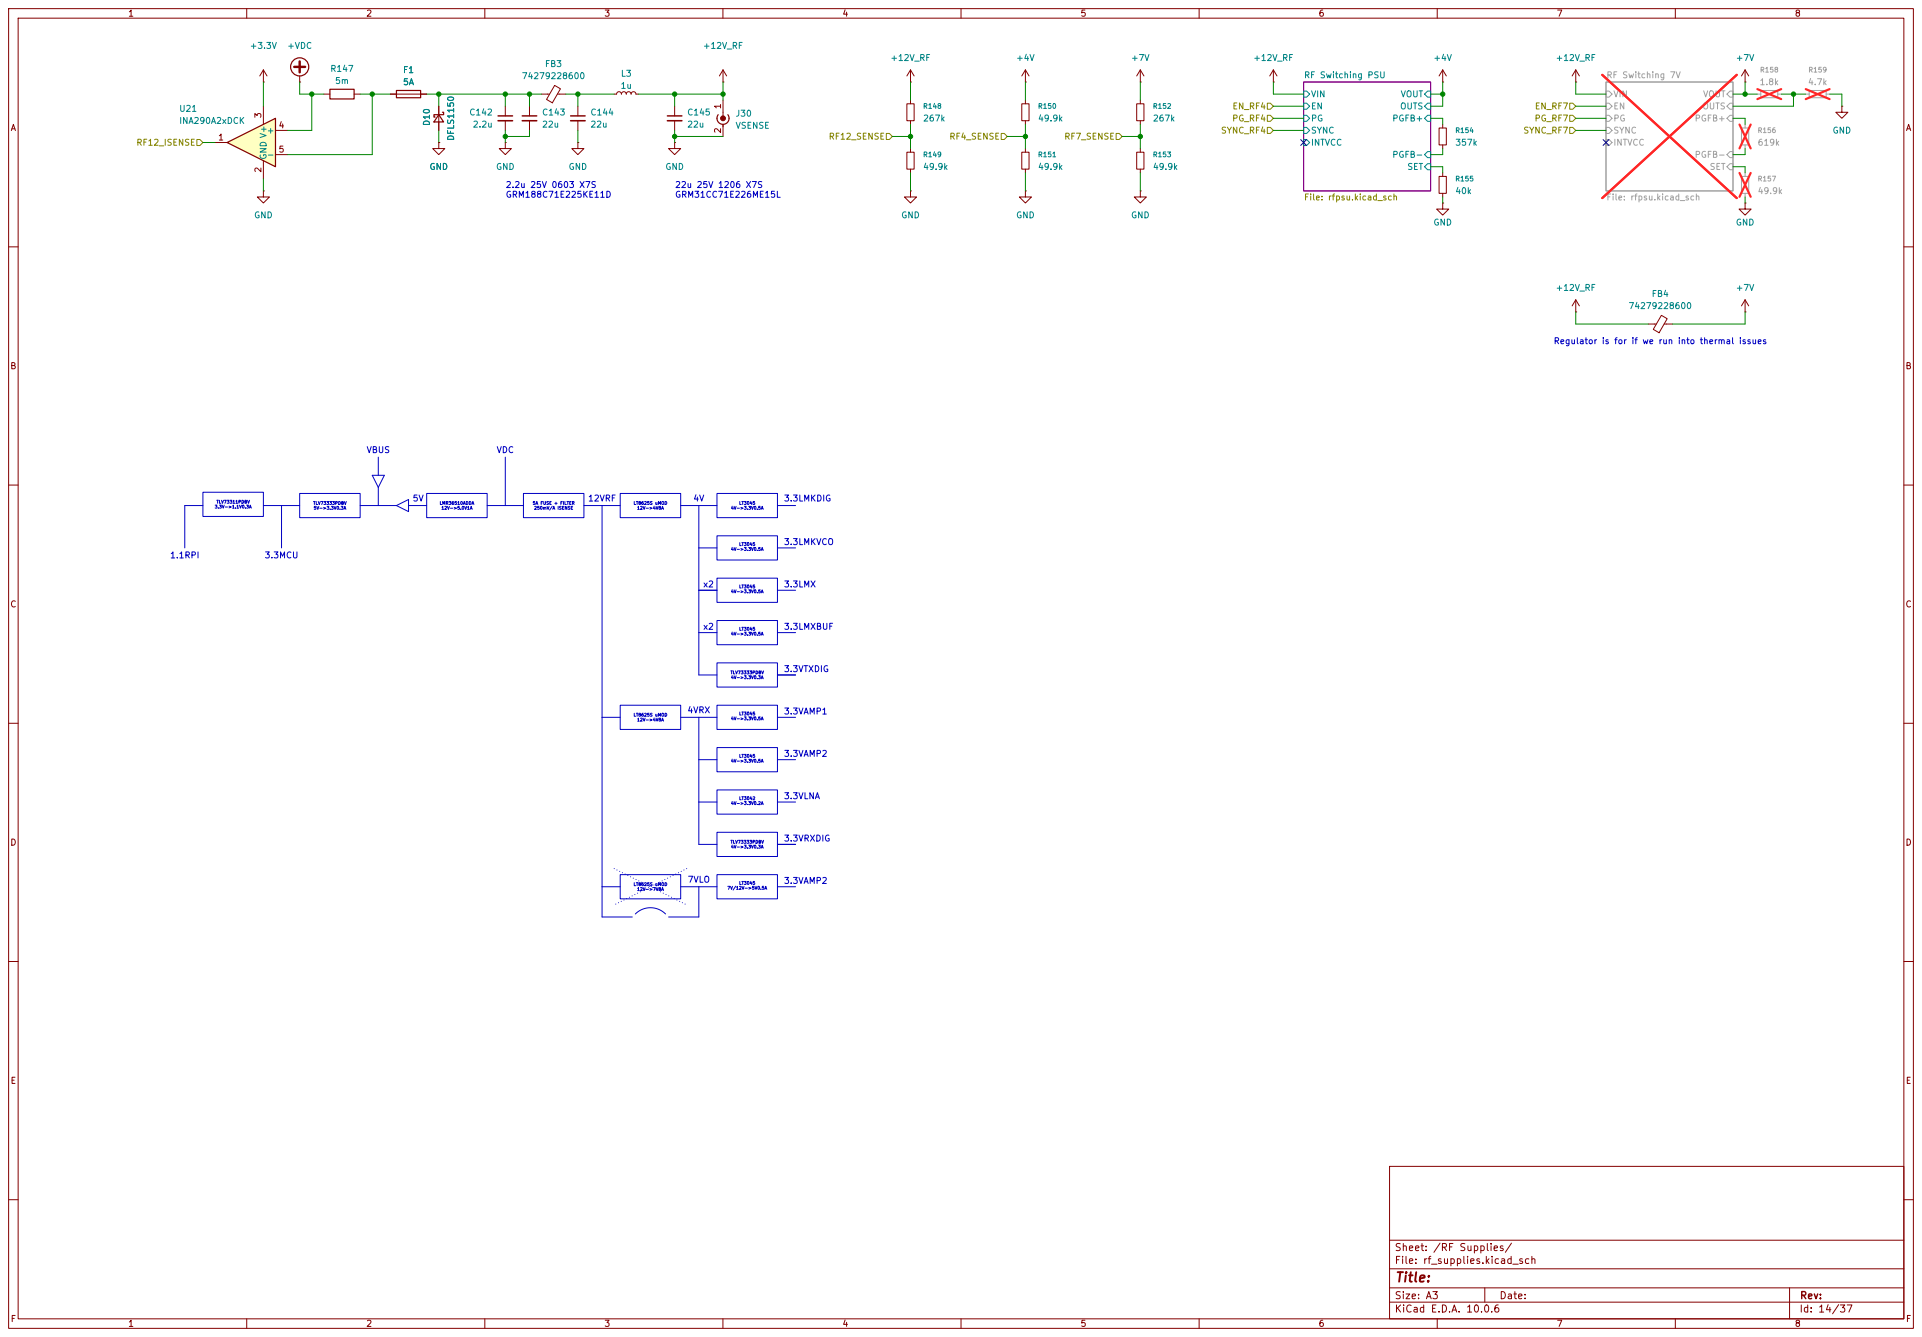
[picture p26: page 26]

Regulator is for if we run into thermal issues

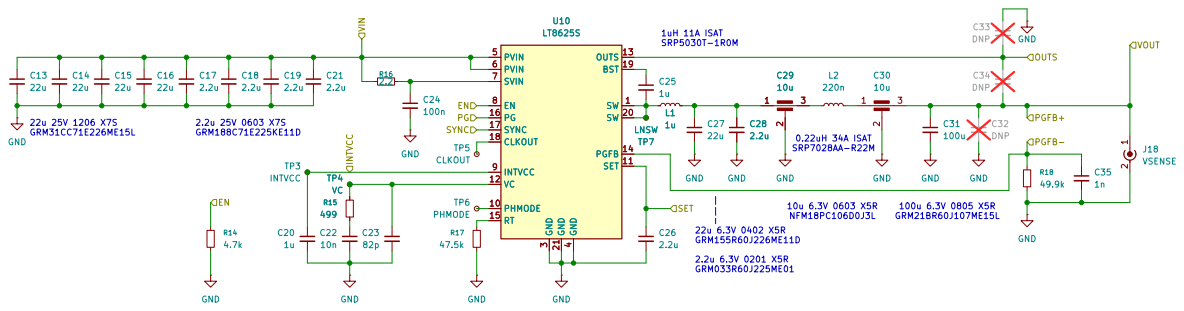
[picture p27: page 27]

Sheet: /RF Supplies/RF Switching PSU/
File: rfpsu.kicad_sch

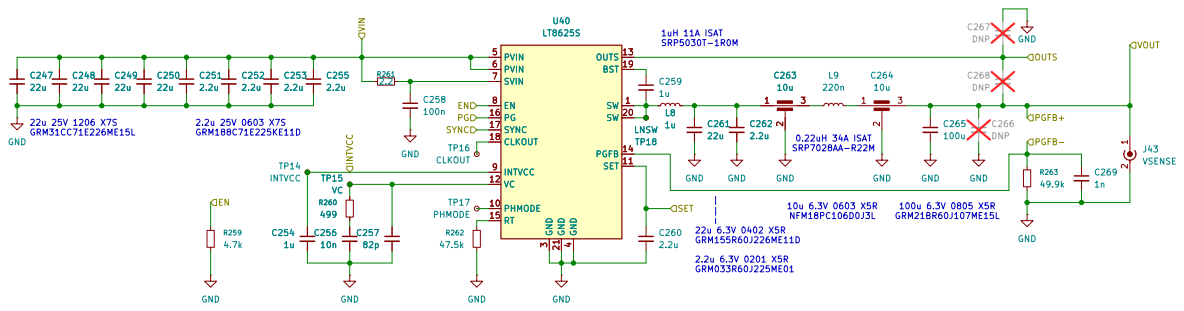
[picture p28: page 28]

Sheet: /RF Supplies/RF Switching 7V/
File: rfpsu.kicad_sch

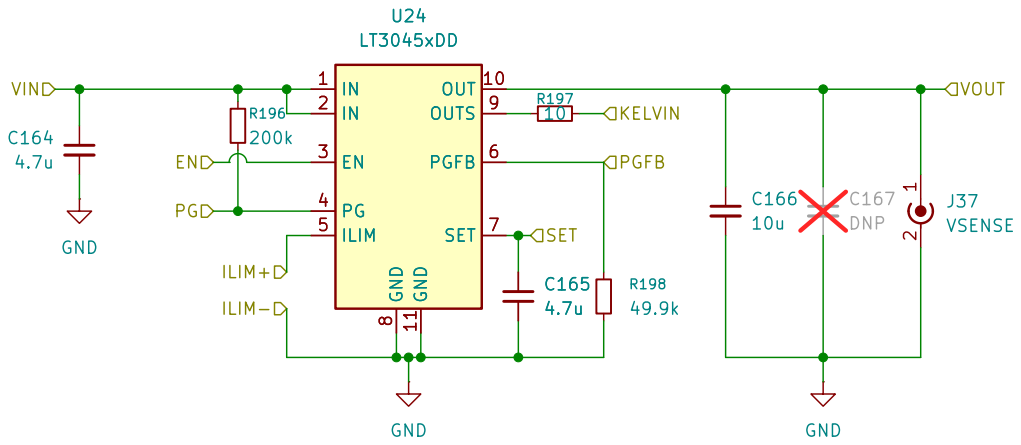
[picture p29: page 29]

Sheet: /Linear LO Drive/
File: linear.kicad_sch

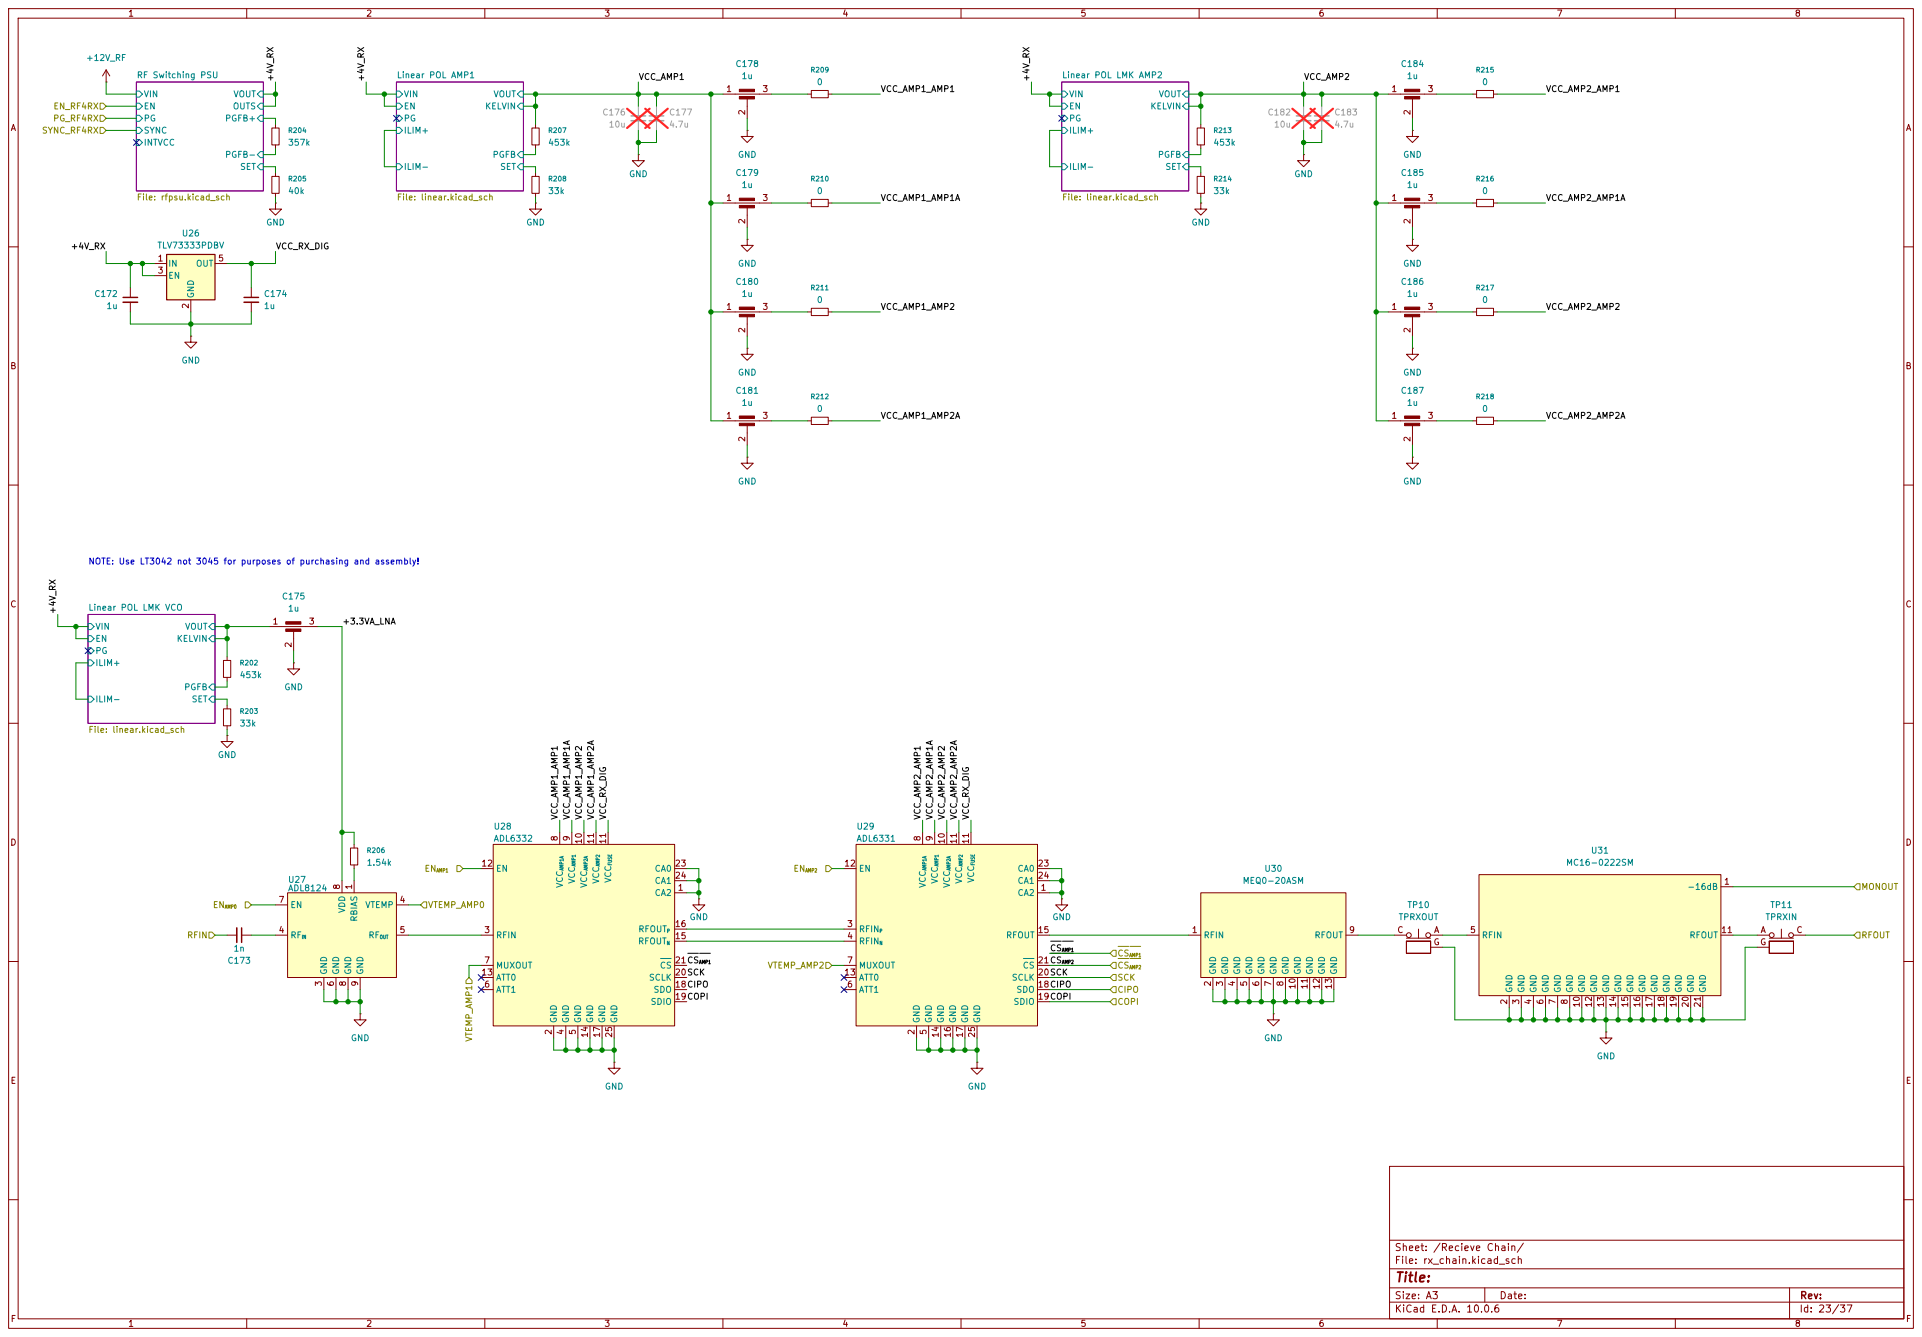
[picture p30: page 30]

VCC_AMP1 NOTE: Use LT3042 not 3045 for purposes of purchasing and assembly!

Linear POL LMK VCO

8 GND 10 RFOUT 11 GND 12 GND 13 GND 14 GND 15 GND 16 GND 17 GND 18 GND 19 GND 20 GND 21 U31 MC16-0222SM

8 RFOUT 9 GND 10 GND 11 GND 12 GND 13 U30 MEQ0-20ASM

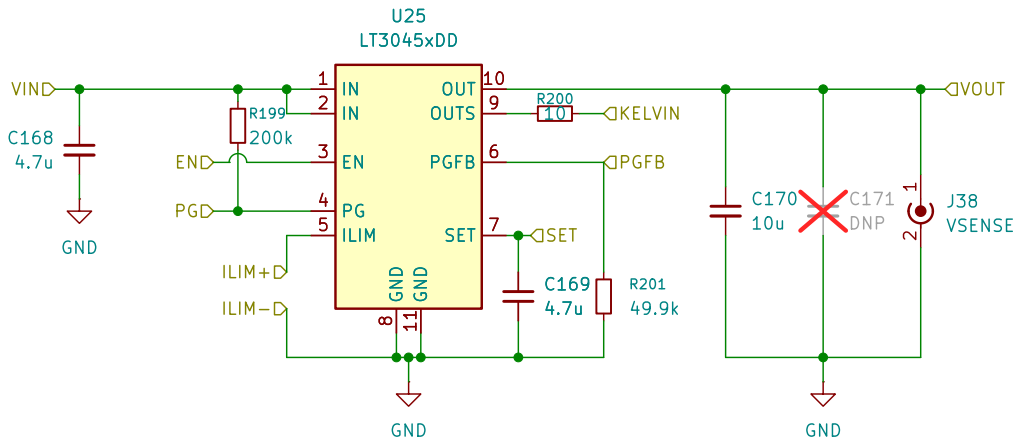
[picture p31: page 31]

Sheet: /Recieve Chain/Linear POL LMK VCO/
File: linear.kicad_sch

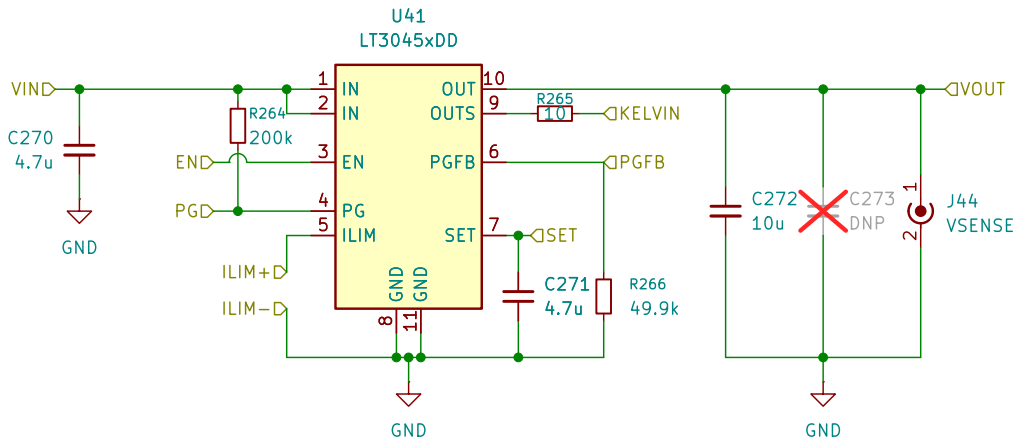
[picture p32: page 32]

Sheet: /Recieve Chain/Linear POL AMP1/
File: linear.kicad_sch

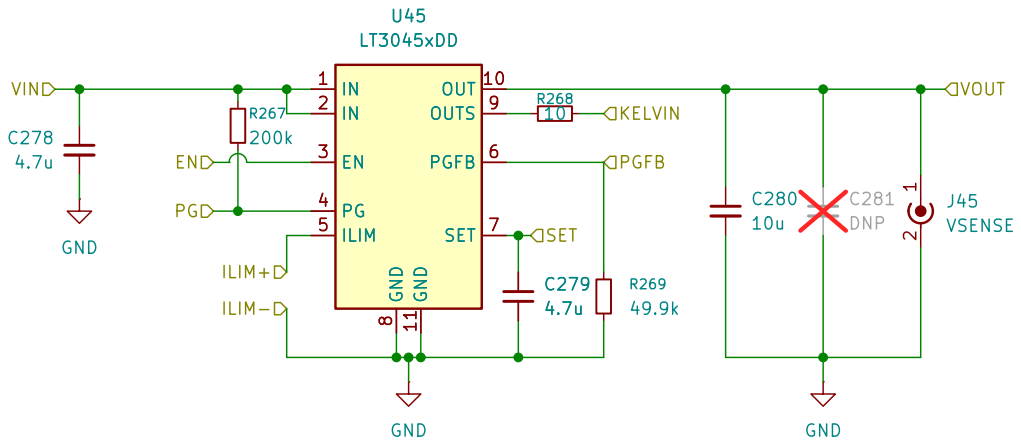
[picture p33: page 33]

Sheet: /Recieve Chain/Linear POL LMK AMP2/
File: linear.kicad_sch

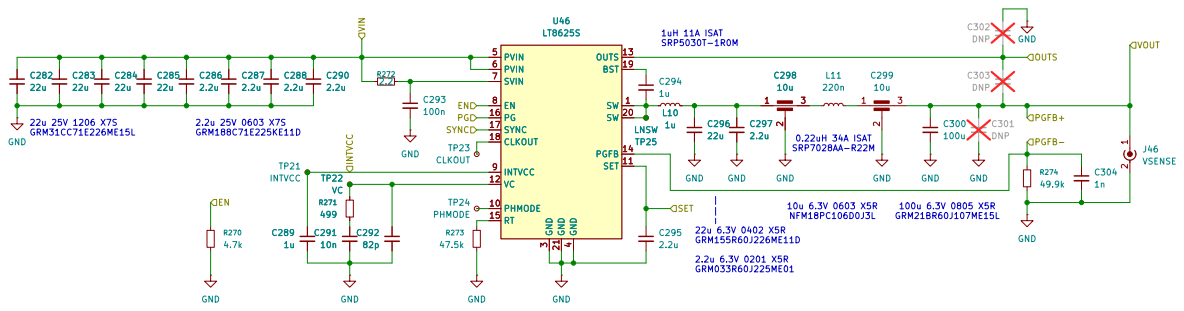
[picture p34: page 34]

Sheet: /Recieve Chain/RF Switching PSU/
File: rfpsu.kicad_sch

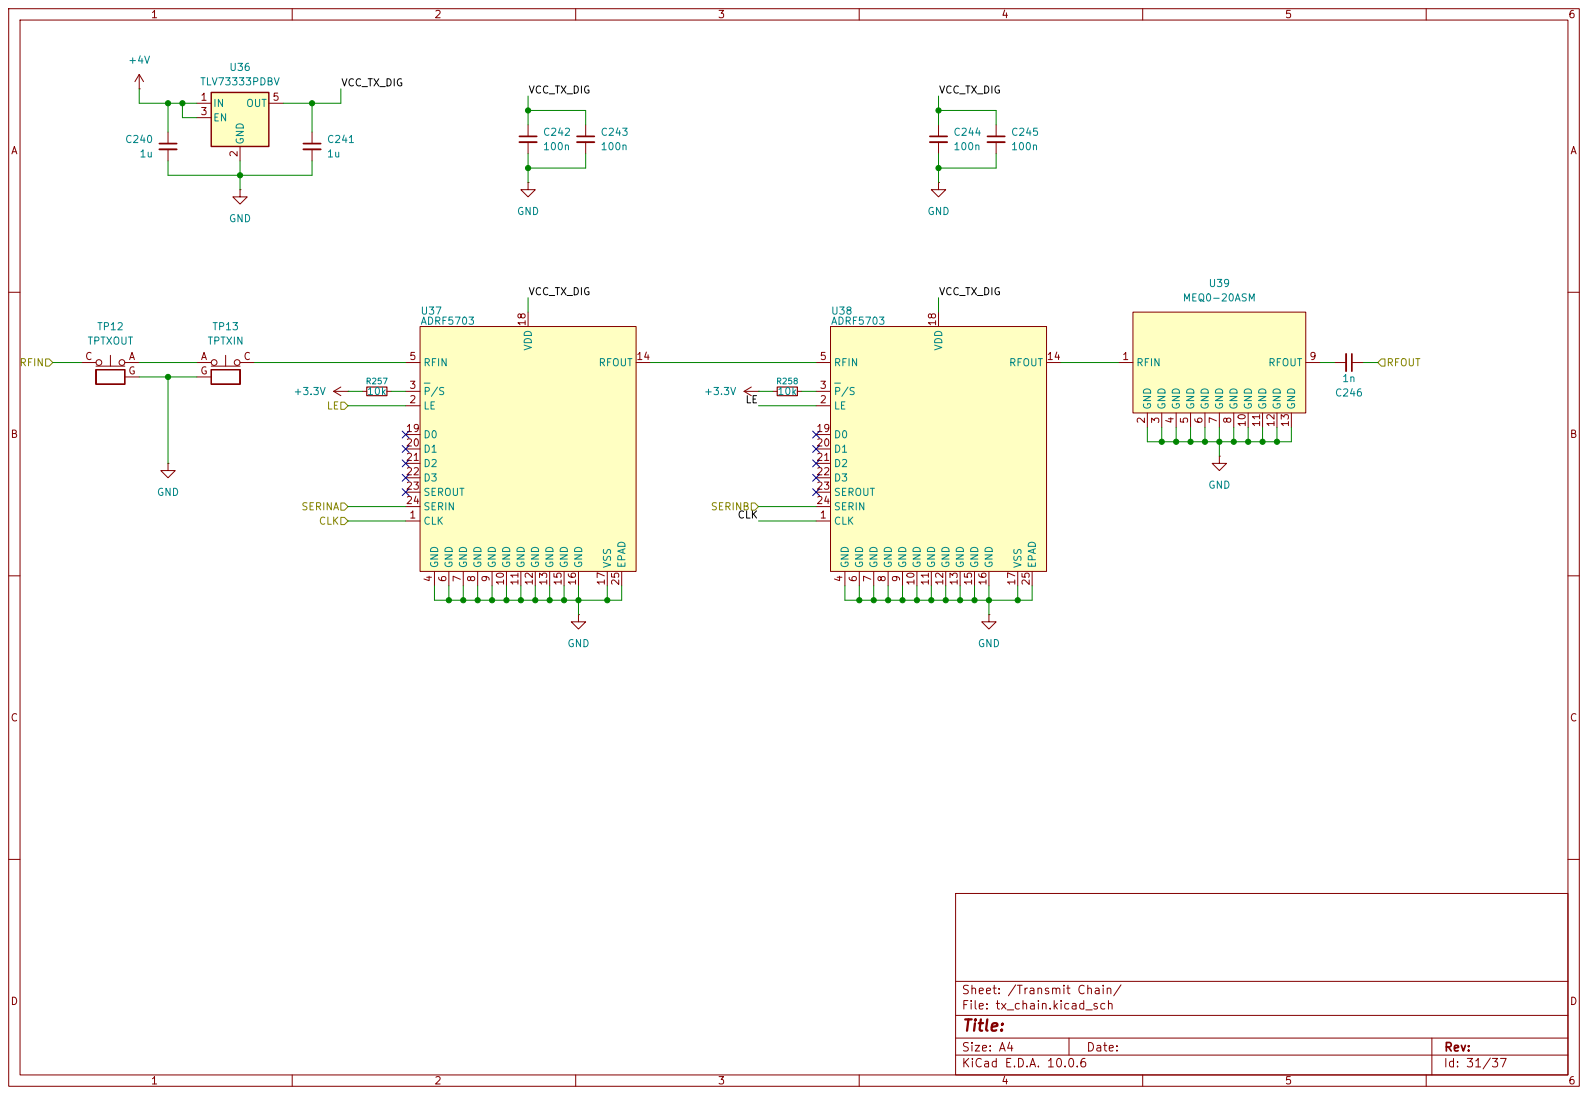
[picture p35: page 35]

8 RFOUT 9 GND 10 GND 11 GND 12 GND 13 U39 MEQ0-20ASM

9 GND 10 GND 11 GND 12 GND 13 RFOUT 14 GND 15 GND 16 VSS 17 VDD 18 D0 19 D1 20 D2 21 D3 22

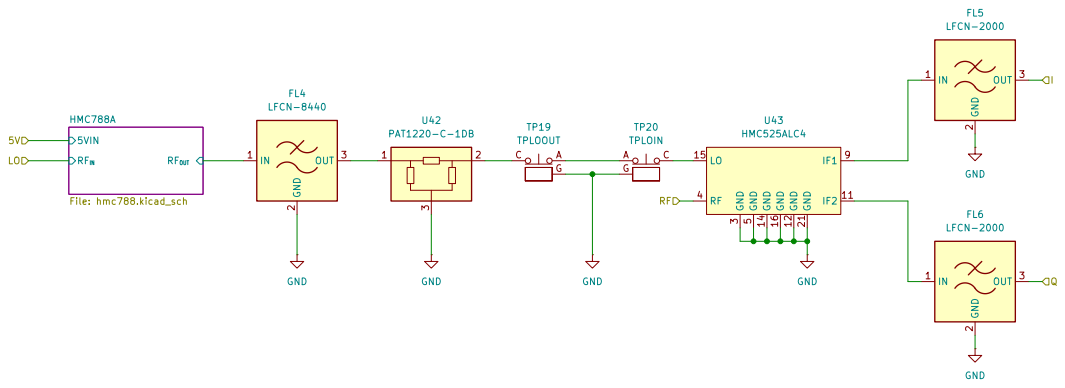
[picture p36: page 36]

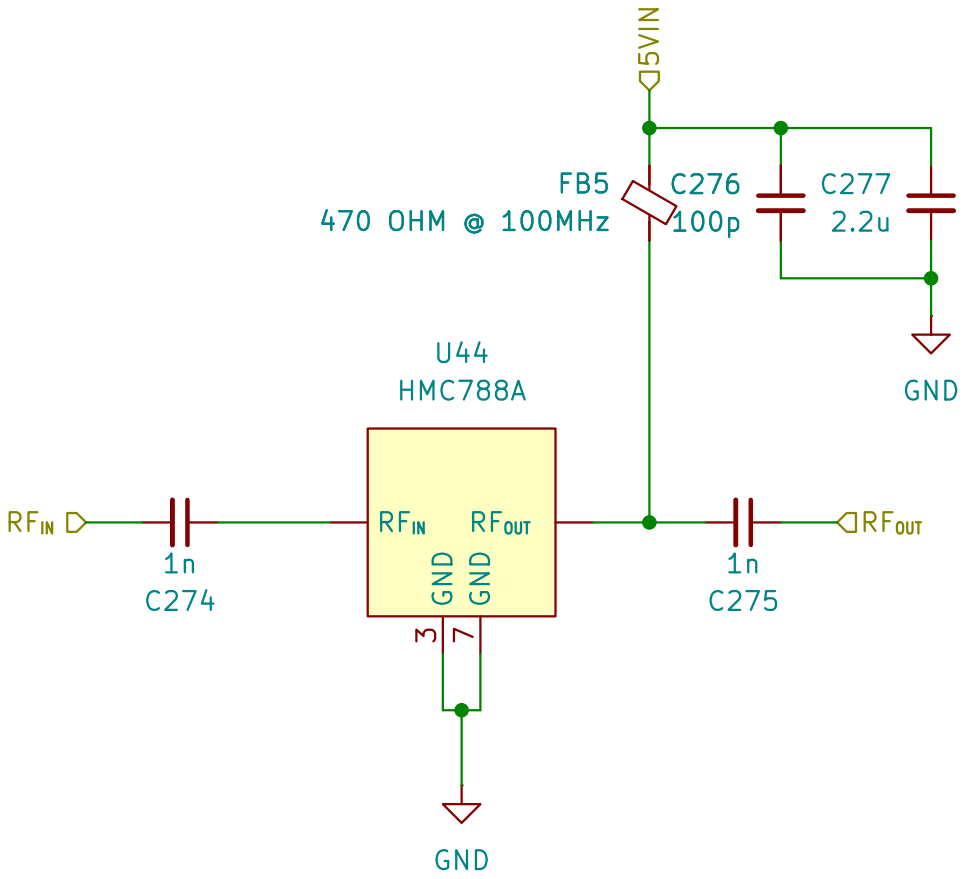
[picture p37: page 37]
