MazinLab/huskypointofload/huskypointofload.kicad_pcb

## KiCad design huskypointofload.kicad_pcb (2025-10-31)

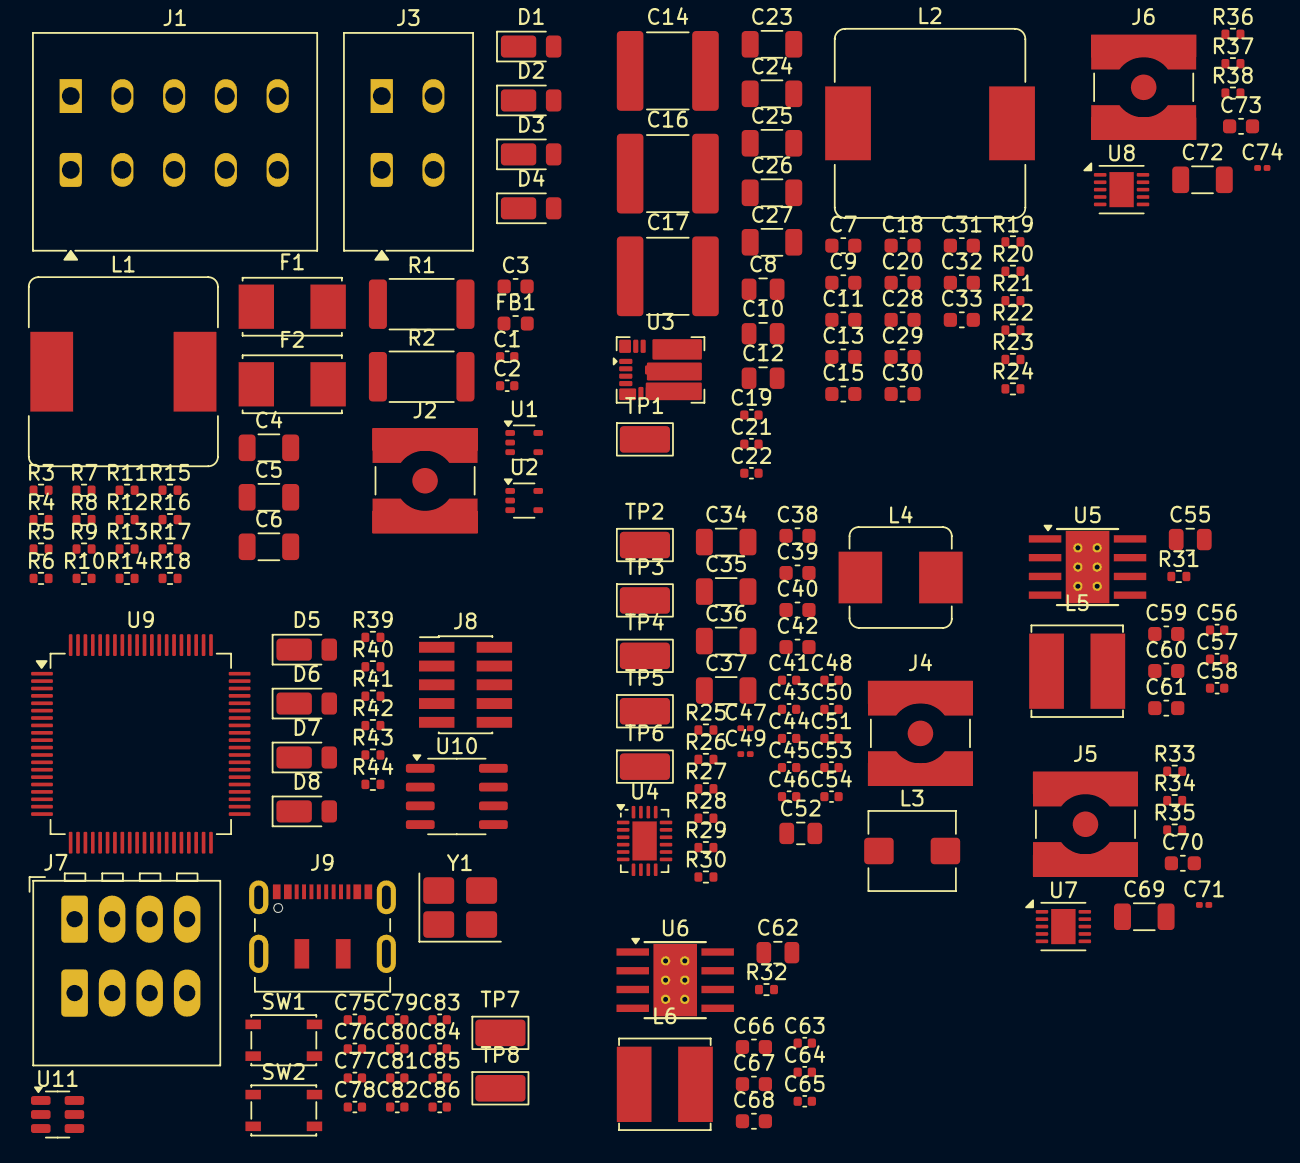
[picture p38: board huskypointofload.kicad_pcb from above]

Board: 6 copper layers, 178 parts (0 on the bottom side), 92 nets, no tracks yet.

Parts:
C1, C2, C22, C45, C58, C65, C81, C82, C83, C84, C85, C86: 100n; C_0402_1005Metric
C3, C18, C20, C28, C29, C30, C31, C32, C33, C38, C39, C40, C42: 2.2u; C_0603_1608Metric
C4, C5, C6, C23, C24, C25, C26, C27, C34, C35, C36, C37: 22u; C_1206_3216Metric
C7, C9, C11, C13, C15: 100n; C_0603_1608Metric
C8, C10, C12, C55, C62: 2.2u; C_0805_2012Metric
C14, C16, C17: 22u; C_2220_5750Metric
C19, C21, C53: DNP; C_0402_1005Metric
C41, C46, C57, C64, C78, C80: 1u; C_0402_1005Metric
C43, C75, C79: 10n; C_0402_1005Metric
C44: 82p; C_0402_1005Metric
C47, C49: 2.2u; C_0201_0603Metric
C48: 22u; C_0402_1005Metric
C50, C51: 10u; C_0402_1005Metric
C52: 100u; C_0805_2012Metric
C54: 470p; C_0402_1005Metric
C56, C63: 220n; C_0402_1005Metric
C59, C60, C61, C66, C67, C68: 22u; C_0603_1608Metric
C69, C72: 4.7u; C_1206_3216Metric
C70, C73: 10u; C_0603_1608Metric
C71, C74: DNP; C_0201_0603Metric
C76, C77: 12p; C_0402_1005Metric
D1, D2, D3, D4, D5, D6, D7, D8: DFLS1150; D_PowerDI-123
F1: 10A; Fuseholder_Littelfuse_Nano2_157x
F2: 5A; Fuseholder_Littelfuse_Nano2_157x
FB1: 74279228600; L_0603_1608Metric
J1: POWER; TerminalBlock_WAGO_2601-1105_1x05_P3.50mm_Horizontal
J2, J4, J5, J6: VSENSE; SMA_Amphenol_132134-10_Vertical
J3: RFSOC_POWER; TerminalBlock_WAGO_2601-1102_1x02_P3.50mm_Horizontal
J7: RS485; TerminalBlock_WAGO_233-504_2x04_P2.54mm
J8: JTAG; PinHeader_2x05_P1.27mm_Vertical_SMD
J9: USB-C; USB_C_Receptacle_JAE_DX07S016JA1R1500
L1: 1u; L_Bourns_SRR1260
L2: 1.5u; L_Bourns_SRP1245A
L3: 1u; L_Bourns_SRP5030T
L4: 220n; L_Bourns_SRP7028A_7.3x6.6mm
L5, L6: 22u; L_Bourns_SRN6045TA
R1, R2: 5m; R_2512_6332Metric
R3, R11: 267k; R_0402_1005Metric
R4, R5, R6, R8, R12, R30, R35, R38: 49.9k; R_0402_1005Metric
R7: 1M; R_0402_1005Metric
R9: 24.9k; R_0402_1005Metric
R10: 43.2k; R_0402_1005Metric
R13: 357k; R_0402_1005Metric
R14: 40k; R_0402_1005Metric
R15, R17: 453k; R_0402_1005Metric
R16, R18: 33k; R_0402_1005Metric
R19, R20: 0; R_0402_1005Metric
R21, R22, R25, R41, R42: 4.7k; R_0402_1005Metric
R23, R24, R27: 2.2; R_0402_1005Metric
R26: 499; R_0402_1005Metric
R28: 47.5k; R_0402_1005Metric
R29, R34, R37: 10; R_0402_1005Metric
R31, R32: 100k; R_0402_1005Metric
R33, R36: 200k; R_0402_1005Metric
R39, R40: 120; R_0402_1005Metric
R43, R44: 27; R_0402_1005Metric
SW1: SYS_RESET; SW_SPST_PTS810
SW2: BOOT0; SW_SPST_PTS810
TP1: GANSW; TestPoint_Keystone_5015_Micro_Mini
TP2: INTVCC; TestPoint_Keystone_5015_Micro_Mini
TP3: VC; TestPoint_Keystone_5015_Micro_Mini
TP4: CLKOUT; TestPoint_Keystone_5015_Micro_Mini
TP5: PHMODE; TestPoint_Keystone_5015_Micro_Mini
TP6: LNSW; TestPoint_Keystone_5015_Micro_Mini
TP7: VBUS; TestPoint_Keystone_5015_Micro_Mini
TP8: BOOT0; TestPoint_Keystone_5015_Micro_Mini
U1, U2: INA290A2xDCK; SOT-353_SC-70-5
U3: EPC23104; EPC_QFN-13-3EP_3.5x5mm_P0.5mm
U4: LT8625S; QFN-20-1EP_3x4mm_P0.5mm_EP1.65x2.65mm
U5, U6: LMR36510ADDA; Texas_HTSOP-8-1EP_3.9x4.9mm_P1.27mm_EP2.95x4.9mm_Mask2.4x3.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
U7, U8: LT3045xDD; DFN-10-1EP_3x3mm_P0.5mm_EP1.65x2.38mm
U9: STM32G474MBTx; LQFP-80_12x12mm_P0.5mm
U10: LTC2851xS8; SOIC-8_3.9x4.9mm_P1.27mm
U11: USBLC6-2SC6; SOT-23-6
Y1: 16MHz; Crystal_SMD_3225-4Pin_3.2x2.5mm_HandSoldering

Connections:
+3.3V: C1.1, C2.1, C66.1, C67.1, C68.1, C79.1, C80.1, C81.1, C82.1, C83.1, C84.1, C85.1, C86.1, D5.1 (K), D6.1 (K), D7.1 (K), D8.1 (K), J8.1 (VTref), L6.2, R41.1, SW2.1 (A), U1.3 (V+), U2.3 (V+), U9.1 (VBAT), U9.16 (VDD), U9.29 (VDDA), U9.41 (VDD), U9.51 (VDD), U9.62 (VDD), U9.80 (VDD), U11.5 (VBUS)
+3.3VA_LMK: C70.1, C71.1, J5.1 (In), R34.2, U7.10 (OUT)
+3.3VA_LMX: C73.1, C74.1, J6.1 (In), R37.2, U8.10 (OUT)
+4V: C52.1, C53.1, C69.1, C72.1, J4.1 (In), R5.1, R13.1, R29.2, R33.1, R36.1, U7.1 (IN), U7.2 (IN), U7.3 (EN), U8.1 (IN), U8.2 (IN), U8.3 (EN)
+5V: C18.1, C59.1, C60.1, C61.1, L5.2, R23.2, U3.5 (VDRV)
+12V: C23.1, C24.1, C25.1, C26.1, C27.1, C28.1, C29.1, C30.1, C31.1, C32.1, C33.1, J1.2, J3.1, L2.2, R1.1, R11.1, U1.4 (+)
+12V_RFSOC: D1.1 (K), F1.2
+48V: C7.1, C8.1, C9.1, C10.1, C11.1, C12.1, C13.1, C14.1, C15.1, C16.1, C17.1, D3.2 (A), J1.3, R7.1, U3.10 (VIN)
+VDC: D4.2 (A), J1.1, R2.1, U2.4 (+)
/BUCK_VIN: D6.2 (A), R7.2, R8.1, U9.13 (PA1)
/BUCK_VOUT: D8.2 (A), R11.2, R12.1, U9.17 (PA3)
/EN_RF: R25.1, U4.8 (EN), U9.34 (PE11)
/House Keeping Supply 3.3V/SET: R10.1, R32.2
/House Keeping Supply 3.3V/VIN: C55.1, C56.1, C62.1, C63.1, D3.1 (K), D4.1 (K), U5.2 (VIN), U5.3 (EN), U6.2 (VIN), U6.3 (EN)
/House Keeping Supply 5V/SET: R9.1, R31.2
/IBC/HS: R19.1, U9.43 (PB12)
/IBC/LS: R20.1, U9.44 (PB13)
/IBC/~EN: U3.3 (SD), U9.35 (PE12)
/Linear POL LMK/PG: R33.2, U7.4 (PG)
/Linear POL LMK/PGFB+: R17.1, U7.6 (PGFB)
/Linear POL LMK/PGFB-: R17.2, R35.1
/Linear POL LMK/SET: R18.1, U7.7 (SET)
/Linear POL LMX/PG: R36.2, U8.4 (PG)
/Linear POL LMX/PGFB+: R15.1, U8.6 (PGFB)
/Linear POL LMX/PGFB-: R15.2, R38.1
/Linear POL LMX/SET: R16.1, U8.7 (SET)
/MCU/BOOT0: R42.1, SW2.2 (B), TP8.1, U9.77 (PB8)
/MCU/BOOT_RX: U9.66 (PC10), U10.2 (RO)
/MCU/BOOT_TX: U9.67 (PC11), U10.3 (DI)
/MCU/D+: J9.A6 (D+), J9.B6 (D+), U11.3 (I/O2)
/MCU/D-: J9.A7 (D-), J9.B7 (D-), U11.1 (I/O1)
/MCU/DESD+: R44.2, U11.4 (I/O2)
/MCU/DESD-: R43.1, U11.6 (I/O1)
/MCU/DMCU+: R44.1, U9.60 (PA12)
/MCU/DMCU-: R43.2, U9.59 (PA11)
/MCU/DRX+: J7.1, R39.1, U10.8 (A)
/MCU/DRX-: J7.2, R39.2, U10.7 (B)
/MCU/DTX+: J7.3, R40.1, U10.6 (Z)
/MCU/DTX-: J7.4, R40.2, U10.5 (Y)
/MCU/NRST: J8.10 (~RESET), R41.2, SW1.1 (A), U9.7 (PG10)
/MCU/PF0: C76.2, U9.5 (PF0), Y1.3
/MCU/PF1: C77.2, U9.6 (PF1), Y1.1
/MCU/TCK: J8.4 (SWCLK/TCK), U9.64 (PA14)
/MCU/TDI: J8.8 (NC/TDI), U9.65 (PA15)
/MCU/TDO: J8.6 (SWO/TDO), U9.73 (PB4)
/MCU/TMS: J8.2 (SWDIO/TMS), U9.63 (PA13)
/PG_RF: U4.16 (PG), U9.33 (PE10)
/RF Switching PSU/PGFB-: C54.1, R13.2, R30.1, U4.14 (PGFB)
/RF Switching PSU/SET: C47.1, R14.1, U4.11 (SET)
/RFA_SENSE: D5.2 (A), R3.2, R4.1, U9.12 (PA0)
/RFB_SENSE: D7.2 (A), R5.2, R6.1, U9.14 (PA2)
/RF_ISENSE: U2.1, U9.9 (PC1)
/SOC_ISENSE: U1.1, U9.8 (PC0)
/SYNC_RF: U4.17 (SYNC), U9.32 (PE9)
GND: C1.2, C2.2, C3.2, C4.2, C5.2, C6.2, C7.2, C8.2, C9.2, C10.2, C11.2, C12.2, C13.2, C14.2, C15.2, C16.2, C17.2, C18.2, C19.2, C20.1, C21.2, C23.2, C24.2, C25.2, C26.2, C27.2, C28.2, C29.2, C30.2, C31.2, C32.2, C33.2, C34.2, C35.2, C36.2, C37.2, C38.2, C39.2, C40.2, C41.2, C42.2, C43.2, C44.2, C45.2, C47.2, C48.2, C49.2, C50.2, C51.2, C52.2, C53.2, C54.2, C55.2, C56.2, C57.2, C59.2, C60.2, C61.2, C62.2, C63.2, C64.2, C66.2, C67.2, C68.2, C69.2, C70.2, C71.2, C72.2, C73.2, C74.2, C75.2, C76.1, C77.1, C78.2, C79.2, C80.2, C81.2, C82.2, C83.2, C84.2, C85.2, C86.2, D1.2 (A), D2.2 (A), J1.5, J2.2 (Ext), J3.2, J4.2 (Ext), J5.2 (Ext), J6.2 (Ext), J8.3 (GND), J8.5 (GND), J8.9 (GNDDetect), J9.A1 (GND), J9.A12 (GND), J9.B1 (GND), J9.B12 (GND), J9.S1 (SHIELD), R4.2, R6.2, R8.2, R9.2, R10.2, R12.2, R14.2, R16.2, R18.2, R21.2, R22.2, R25.2, R28.2, R30.2, R35.2, R38.2, R42.2, SW1.2 (B), U1.2 (GND), U2.2 (GND), U3.7 (AGND), U3.8 (PGND), U4.3 (GND), U4.4 (GND), U4.21 (GND), U5.1 (PGND), U5.9 (PAD), U6.1 (PGND), U6.9 (PAD), U7.5 (ILIM), U7.8 (GND), U7.11 (GND), U8.5 (ILIM), U8.8 (GND), U8.11 (GND), U9.15 (VSS), U9.27 (VSSA), U9.40 (VSS), U9.50 (VSS), U9.61 (VSS), U9.79 (VSS), U11.2 (GND), Y1.2, Y1.4
unnamed: C5.1, FB1.2, L1.2
unnamed: C43.1, R26.2
unnamed: C46.2, L3.1, TP6.1, U4.1 (SW), U4.20 (SW)
unnamed: C48.1, C49.1, C50.1, L3.2
unnamed: C51.1, L4.2
unnamed: C3.1, C4.1, D2.1 (K), F2.2, FB1.1
unnamed: J9.A4 (VBUS), J9.A9 (VBUS), J9.B4 (VBUS), J9.B9 (VBUS), TP7.1
unnamed: F1.1, R1.2, U1.5 (-)
unnamed: F2.1, R2.2, U2.5 (-)
unnamed: C19.1, R19.2, R21.1, U3.1 (HSIN)
unnamed: C21.1, R20.2, R22.1, U3.2 (LSIN)
unnamed: R24.2, U3.12 (RBOOT)
unnamed: R23.1, U3.6 (RDRV)
unnamed: L2.1, TP1.1, U3.9 (SW)
unnamed: C22.1, R24.1, U3.13 (VBOOT)
unnamed: C20.2, U3.4 (VDD)
unnamed: C22.2, U3.11 (VPHASE)
unnamed: C46.1, U4.19 (BST)
unnamed: TP4.1, U4.18 (CLKOUT)
unnamed: C41.1, TP2.1, U4.9 (INTVCC)
unnamed: R29.1, U4.13 (OUTS)
unnamed: TP5.1, U4.10 (PHMODE)
unnamed: R28.1, U4.15 (RT)
unnamed: C45.1, R27.1, U4.7 (SVIN)
unnamed: C44.1, R26.1, TP3.1, U4.12 (VC)
unnamed: C58.1, U5.7 (BOOT)
unnamed: R31.1, U5.5 (FB)
unnamed: C58.2, L5.1, U5.8 (SW)
unnamed: C57.1, U5.6 (VCC)
unnamed: C65.1, U6.7 (BOOT)
unnamed: R32.1, U6.5 (FB)
unnamed: C65.2, L6.1, U6.8 (SW)
unnamed: C64.1, U6.6 (VCC)
unnamed: R34.1, U7.9 (OUTS)
unnamed: R37.1, U8.9 (OUTS)
VBUS: C6.1, C34.1, C35.1, C36.1, C37.1, C38.1, C39.1, C40.1, C42.1, J1.4, J2.1 (In), L1.1, R3.1, R27.2, U4.5 (PVIN), U4.6 (PVIN)
VREF+: C75.1, C78.1, U9.28 (VREF+)
