MazinLab/huskypointofload/(commit log)

2025-10-30 Add initial schematic for power
    [MCU.kicad_sch, house.kicad_sch, huskypointofload.kicad_pcb, huskypointofload.kicad_sch, ibc.kicad_sch, linear.kicad_sch, rfpsu.kicad_sch]
2025-10-30 Fix typo add bom
    [bom.xlsx, huskypointofload.kicad_sch]
2025-10-31 Add PCB
    [huskypointofload.kicad_pcb]
2025-11-01 reorg and add 10MHz
    [MCU.kicad_sch, buffer_10MHz.kicad_sch, clocking.kicad_sch, dist10.kicad_sch, huskypointofload.kicad_sch, ibc.kicad_sch, linear.kicad_sch, rf_supplies.kicad_sch]
2025-11-03 Renumber refdes
    [MCU.kicad_sch, buffer_10MHz.kicad_sch, clocking.kicad_sch, dist10.kicad_sch, house.kicad_sch, huskypointofload.kicad_sch, ibc.kicad_sch, linear.kicad_sch]
2025-11-06 Add lmk and bump schematic size
    [MCU.kicad_sch, buffer_10MHz.kicad_sch, clocking.kicad_sch, dist10.kicad_sch, house.kicad_sch, huskypointofload.kicad_sch, ibc.kicad_sch, linear.kicad_sch]
2025-11-06 Complete LMK schematic
    [clocking.kicad_sch, hf_output.kicad_sch, lf_balun_output.kicad_sch, linear.kicad_sch, lmk04828.kicad_sch]
2026-01-06 Add LMX Draft
    [MCU.kicad_sch, buffer_10MHz.kicad_sch, clocking.kicad_sch, dist10.kicad_sch, hf_output.kicad_sch, huskypointofload.kicad_sch, lf_balun_output.kicad_sch, linear.kicad_sch]
2026-01-07 Different Matching Circuit
    [MCU.kicad_sch, clocking.kicad_sch, huskypointofload.kicad_sch, linear.kicad_sch, lmk04828.kicad_sch, lmx2594.kicad_sch, lmxmatch.kicad_sch, lmxmatchsingle.kicad_sch]
2026-01-08 Add mixer
    [clocking.kicad_sch, hmc525.kicad_sch, hmc788.kicad_sch, huskypointofload.kicad_sch, lmxmatchsingle.kicad_sch, rf_supplies.kicad_sch, rfpsu.kicad_sch]
2026-01-09 WIP Splitrail
    [huskypointofload.kicad_sch, rf_supplies.kicad_sch, splitrail.kicad_sch]
2026-01-15 Add VVA Bias generator
    [bias_gen.kicad_sch, huskypointofload.kicad_sch, rf_supplies.kicad_sch, splitrail.kicad_sch]
2026-08-05 wip stuff
    [MCU.kicad_sch, bias_gen.kicad_sch, bom.xlsx, buffer_10MHz.kicad_sch, clocking.kicad_sch, dist10.kicad_sch, hf_output.kicad_sch, hmc525.kicad_sch]
2026-08-10 For Darrel
    [MCU.kicad_sch, bias_gen.kicad_sch, buffer_10MHz.kicad_sch, clocking.kicad_sch, dist10.kicad_sch, hf_output.kicad_sch, hmc525.kicad_sch, hmc788.kicad_sch]
2026-09-16 Rework RF Supplies
    [MCU.kicad_sch, huskypointofload.kicad_sch, linear.kicad_sch, rfpsu.kicad_sch, rx_chain.kicad_sch]
2026-09-16 Add Clock sources and monitor output
    [MCU.kicad_sch, clocking.kicad_sch, hf_output.kicad_sch, hmc788.kicad_sch, huskypointofload.kicad_sch, lf_balun_output.kicad_sch, linear.kicad_sch, lmk04828.kicad_sch]
2026-09-18 It's finished (well the draft)
    [MCU.kicad_sch, huskypointofload.kicad_sch, rf_supplies.kicad_sch, rx_chain.kicad_sch]
2026-09-29 Round 1 review comments
    [MCU.kicad_sch, clocking.kicad_sch, hf_output.kicad_sch, hmc525.kicad_sch, hmc788.kicad_sch, house.kicad_sch, huskypointofload.kicad_sch, lf_balun_output.kicad_sch]
2026-09-29 Round 2 Review, power tree cleanup
    [MCU.kicad_sch, clocking.kicad_sch, hf_output.kicad_sch, hmc525.kicad_sch, hmc788.kicad_sch, house.kicad_sch, huskypointofload.kicad_sch, lf_balun_output.kicad_sch]
2026-09-29 Darrel Suggestions
    [MCU.kicad_sch, clocking.kicad_sch, hf_output.kicad_sch, hmc525.kicad_sch, hmc788.kicad_sch, house.kicad_sch, huskypointofload.kicad_sch, lf_balun_output.kicad_sch]
2026-09-30 Passive footprint pass
    [MCU.kicad_sch, clocking.kicad_sch, hf_output.kicad_sch, hmc788.kicad_sch, huskypointofload.kicad_sch, lf_balun_output.kicad_sch, linear.kicad_sch, lmk04828.kicad_sch]
2026-11-02 add footprints for parts where Kicad libraries were not suitable
2026-11-02 assign footprints, add mounting hole symbols
2026-11-02 fix SMP_V footprint name
2026-11-03 some rough preliminary placement mostly connectors
2026-11-03 assign footprint to missed capacitor
2026-11-03 huskypointofload.[linear,rfpsu]: use U.Fl power testpoints
2026-11-04 huskypointofload.hmc788: don't short the RF to ground...
2026-11-06 add buffers, simplify power tree, switch to bigger rp2350 package
2026-11-06 use LT3045 for first stage amp
2026-11-06 Add capacitive jumper notes
2026-11-06 Add load switch on backup osc
2026-11-06 add footprint to buffer
